PiSupply/PiJuice-mPCIe/README.md

# PiJuice-mPCIe
Resources for the PiJuice mPCIe board
