PiSupply/PiJuice-mPCIe/Hardware/README.md

# Hardware
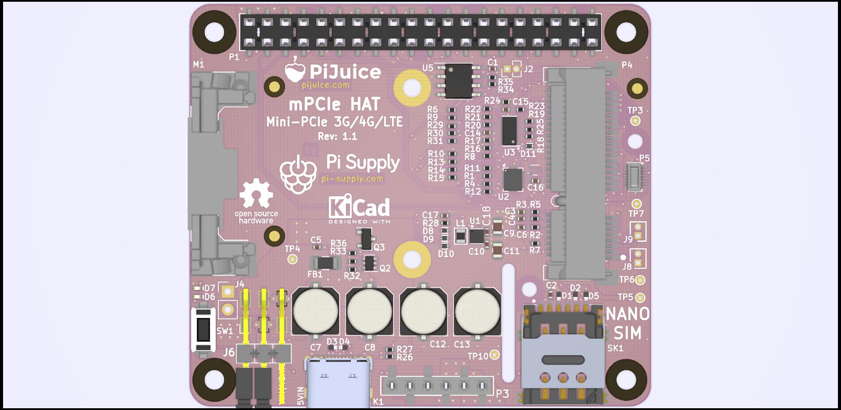
[picture p1: Hardware/Outputs/Assembly/PiJuice_mPCIe_HAT_top.jpg]
Top Side


EC25 datasheets - https://www.quectel.com/ProductDownload/EC25MiniPCIe.html

Change Log:

- V1.1_2021_12_30
    - Q2B connection fix
    - Position file generated
