PiSupply/PiJuice-mPCIe/Hardware/Outputs/gerbers/PiJuice_mPCIe_HAT_PCB_bottom.jpg

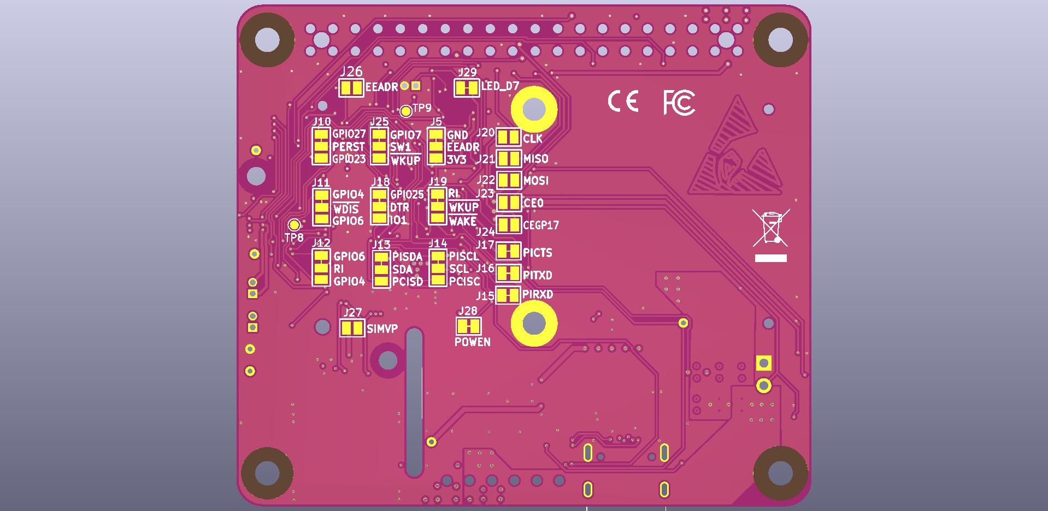
Hardware/Outputs/gerbers/PiJuice_mPCIe_HAT_PCB_bottom.jpg
