PiSupply/PiJuice-mPCIe/Hardware/Outputs/gerbers/PiJuice_mPCIe_HAT_PCB_top.jpg

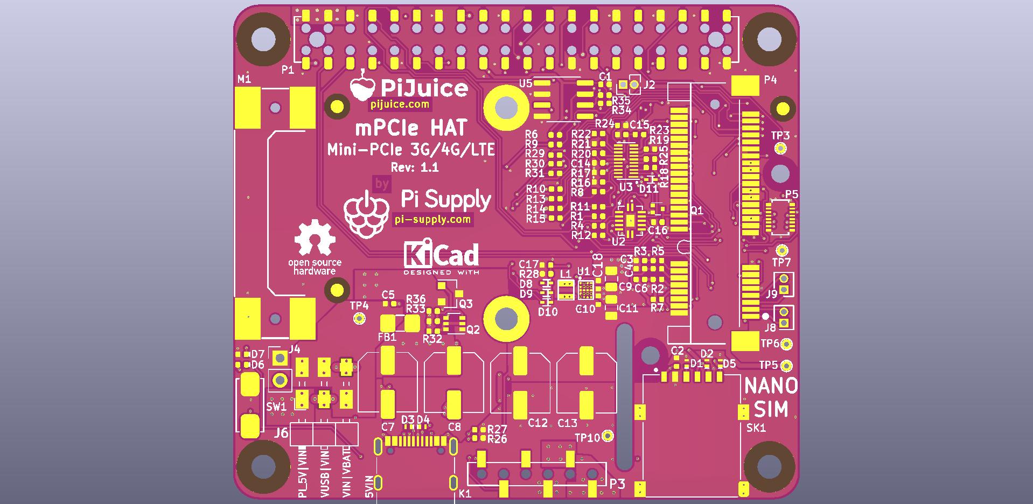
Hardware/Outputs/gerbers/PiJuice_mPCIe_HAT_PCB_top.jpg
