PiSupply/PiJuice-mPCIe/Hardware/Test_card/Outputs/mPCIe_test_card_BOM.csv

Reference | Quantity | Value | Footprint | Datasheet | Description | Part Number
R1 | 1 | 47R | Resistor_THT:R_Axial_DIN0414_L11.9mm_D4.5mm_P15.24mm_Horizontal | ~ | RES 47 OHM 1W 1% AXIAL | KNP100FR-73-47R
