PiSupply/PiJuice-mPCIe/Hardware/Outputs/Assembly/PiJuice_mPCIe_bottom.jpg

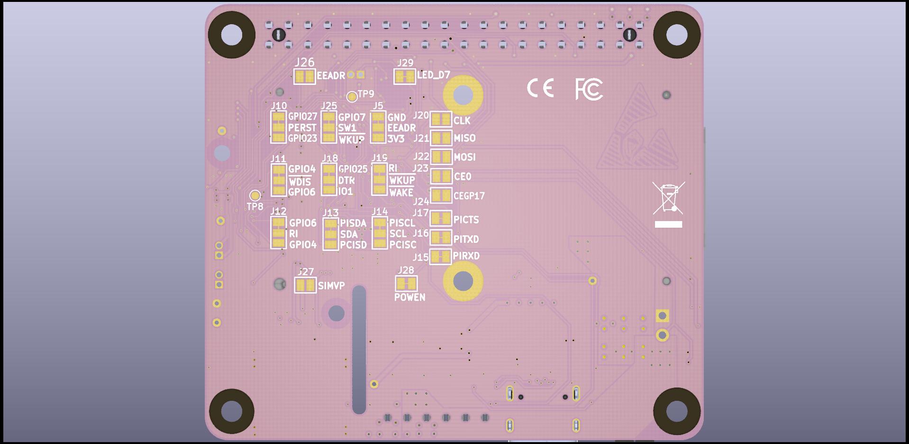
Hardware/Outputs/Assembly/PiJuice_mPCIe_bottom.jpg
