PiSupply/PiJuice-mPCIe/Hardware/Test_card/README.md

# mPCIe Test Card design 

Used for testing PiJuice mPCIe HATs 

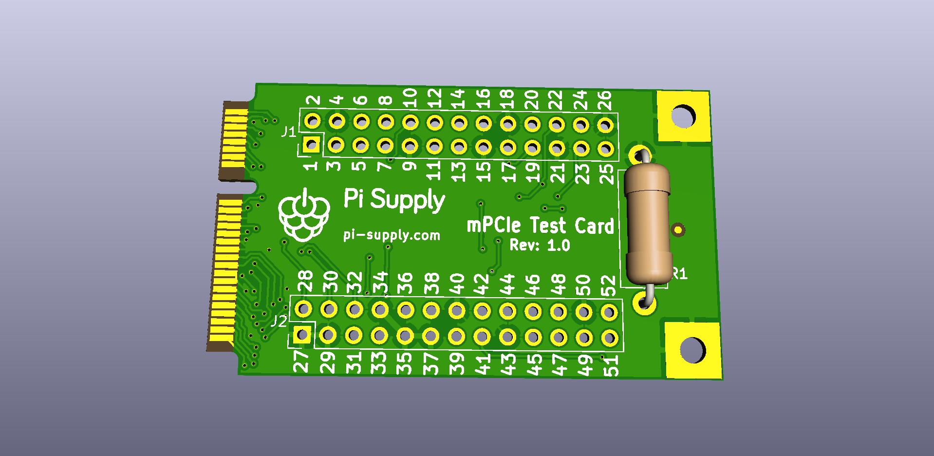
[picture p5: Hardware/Test_card/Outputs/mPCIe_test_card.jpg]
top
