PiSupply/PiJuice-mPCIe/Hardware/Test_card/mPCIe_test_card.jpg

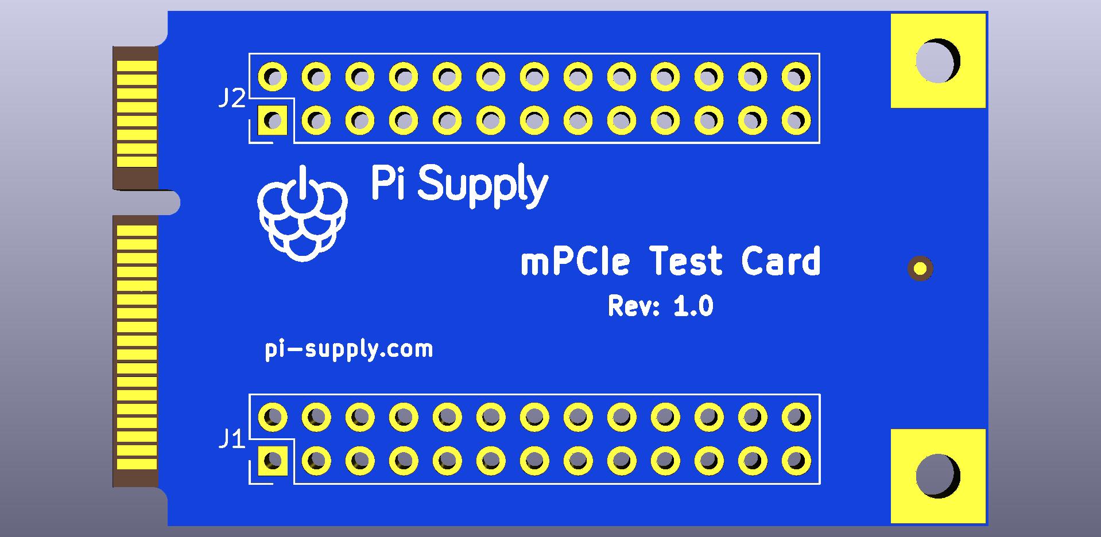
Hardware/Test_card/mPCIe_test_card.jpg
