PiSupply/PiJuice-mPCIe/Hardware/Outputs/PiJuice_mPCIe_HAT_Schematic.pdf

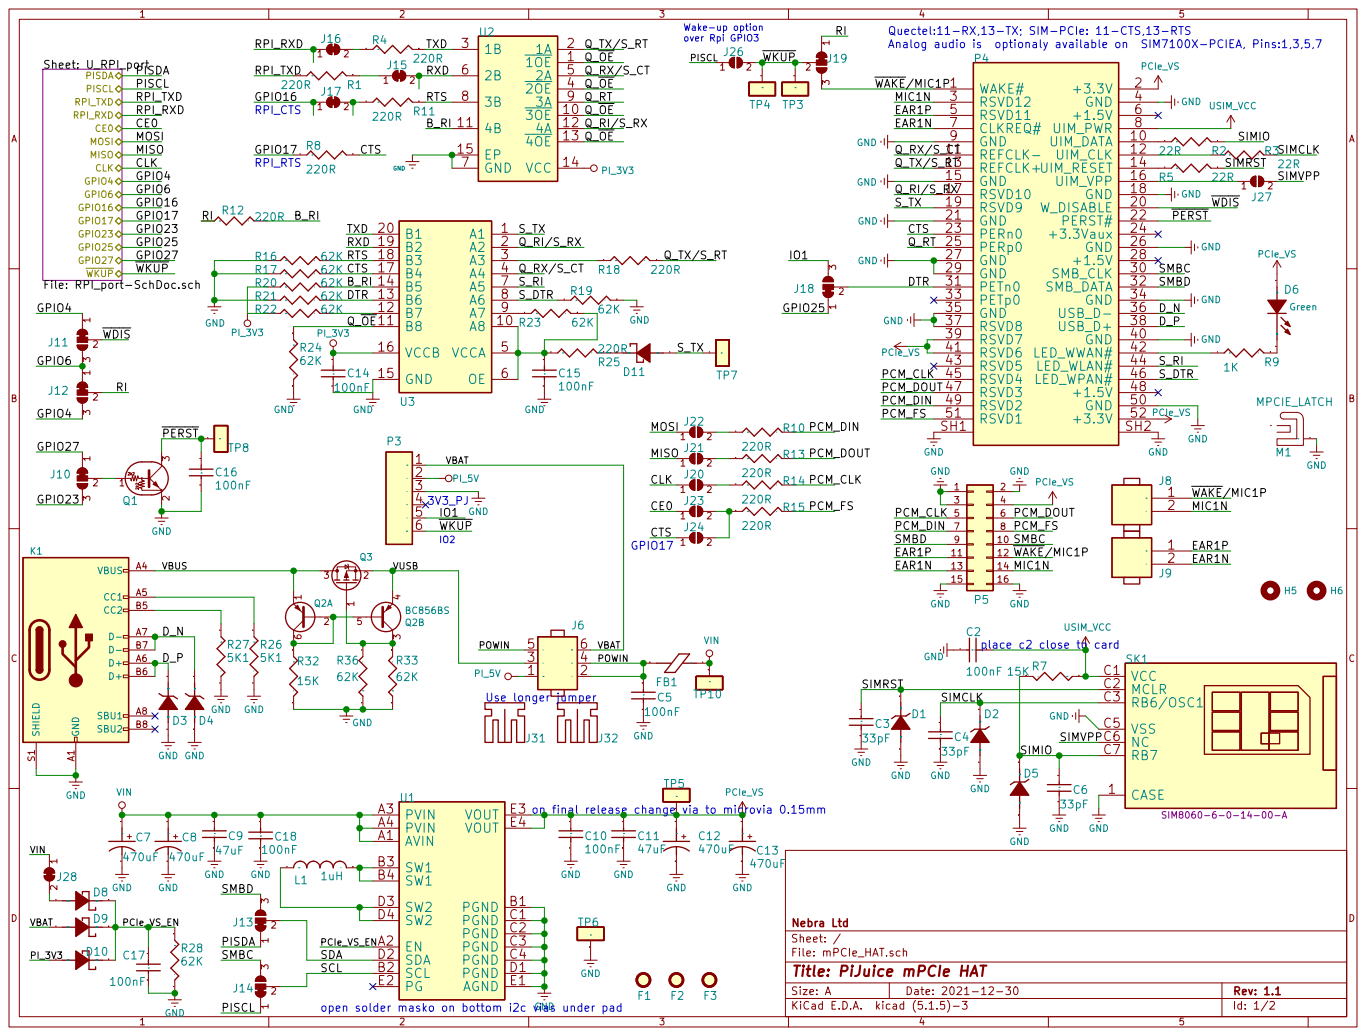
[picture p7: page 1]

Analog audio is optionaly available on SIM7100X-PCIEA, Pins:1,3,5,7

EAR1P 11 | 12 MIC1N WAKE/MIC1P
EAR1N 13 | 14

place c2 close to card

VCC C1

SIMCLK | | | RB6/OSC1 C3

SIMVPP SIMIO | VSS C5

on final release change via to microvia 0.15mm

File: mPCIe_HAT.sch Sheet: / Nebra Ltd

Id: 1/2 Title: PiJuice mPCIe HAT

open solder masko on bottom i2c vias under pad

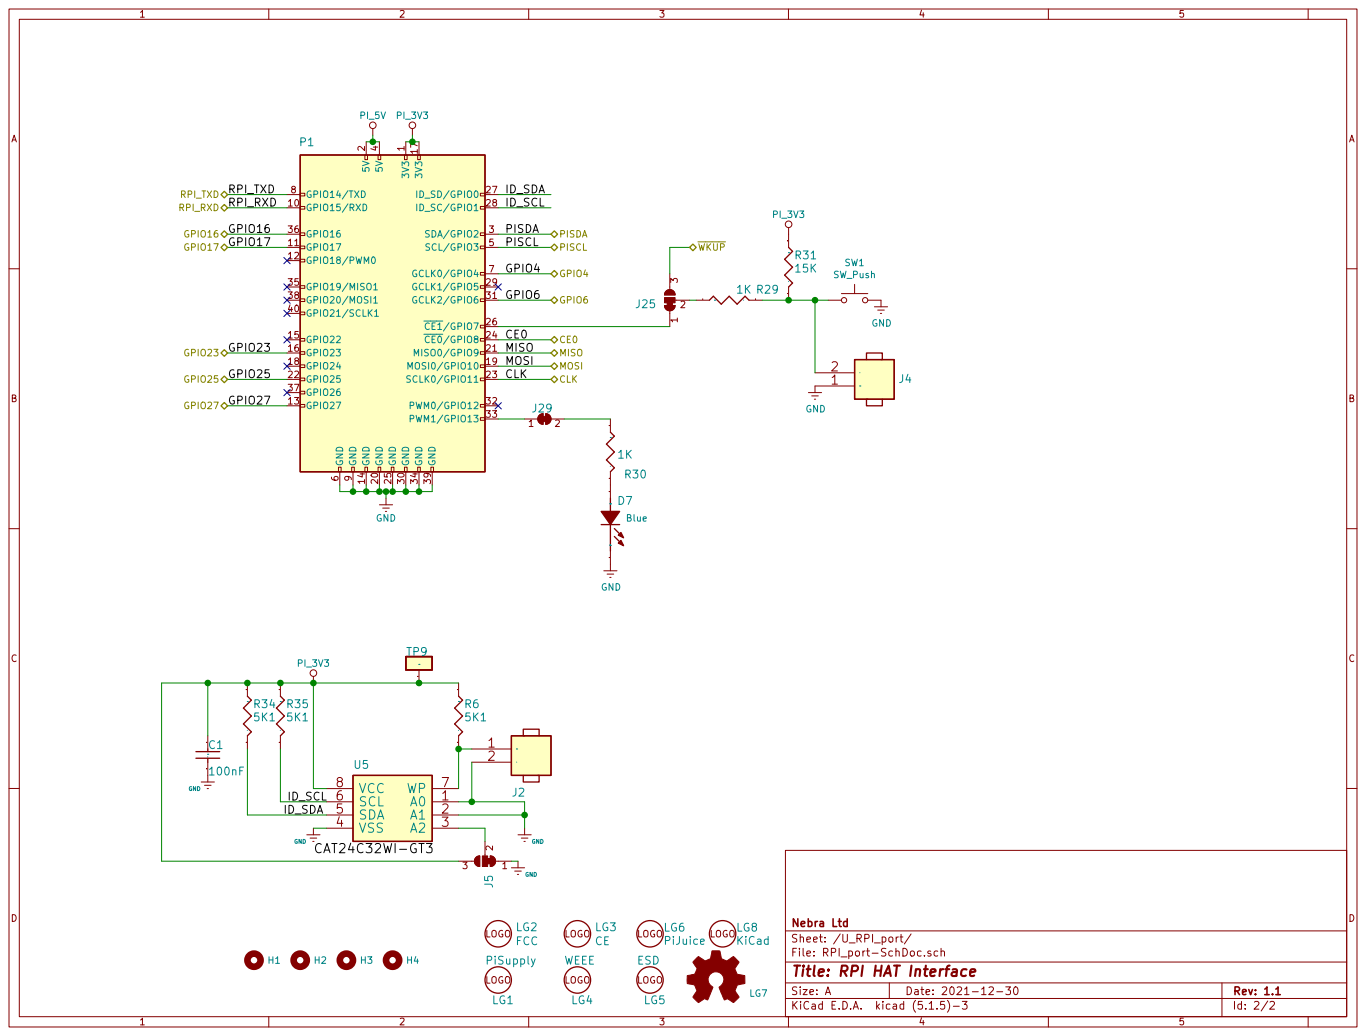
[picture p8: page 2]

3 J25 1 1 2 2 J4 GPIO4 WKUP CLK MOSI MISO

File: RPI_port-SchDoc.sch
Id: 2/2 Title: RPI HAT Interface
