PiSupply/PiJuice-mPCIe/Hardware/Outputs/PiJuice_mPCIe_HAT_Layers.pdf

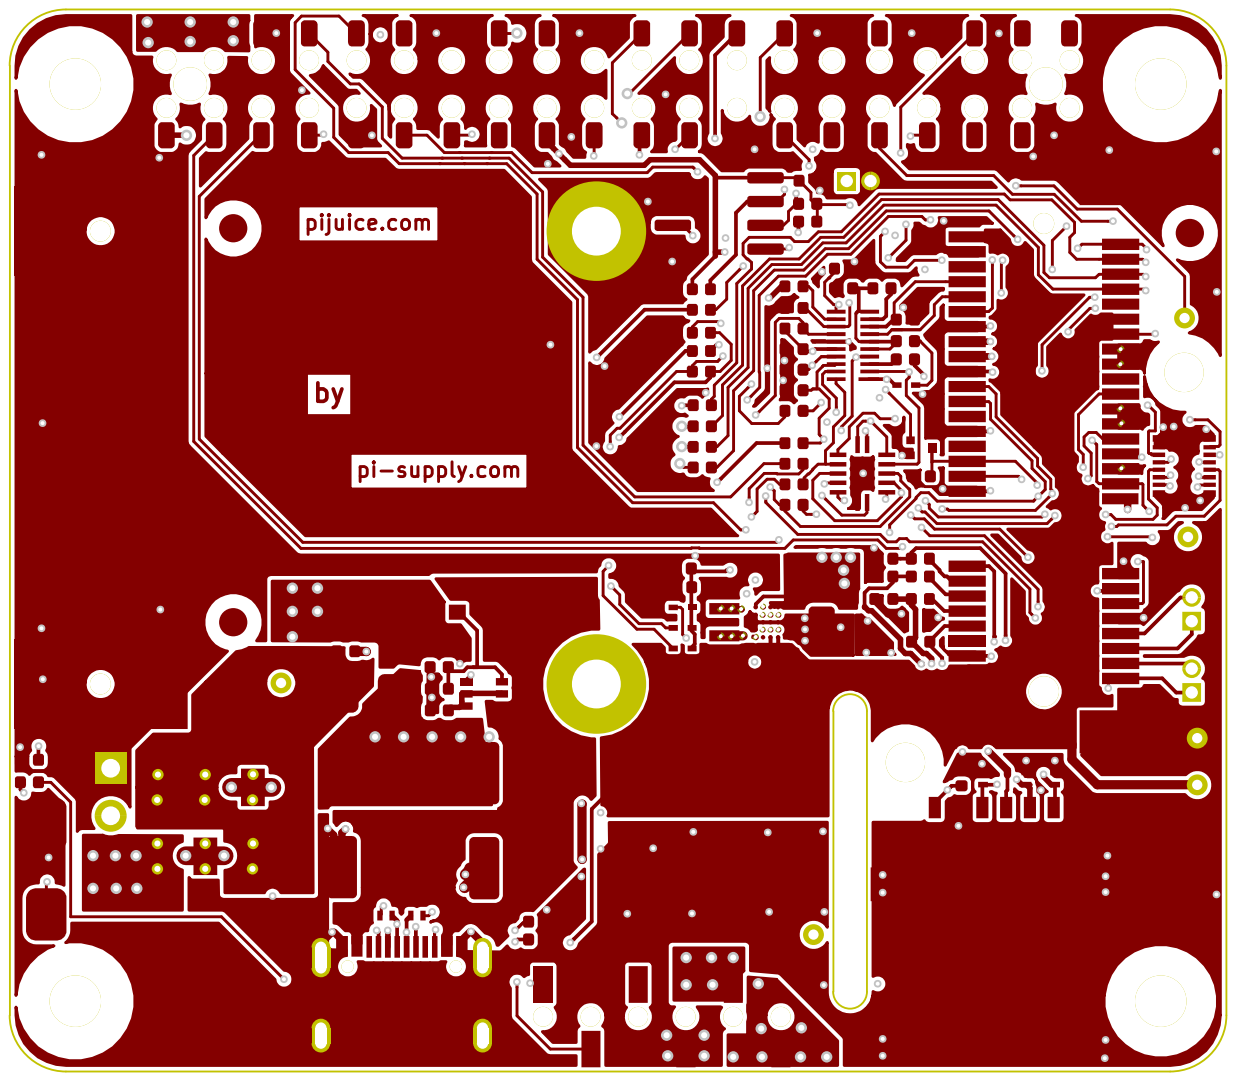
[picture p9: page 1]

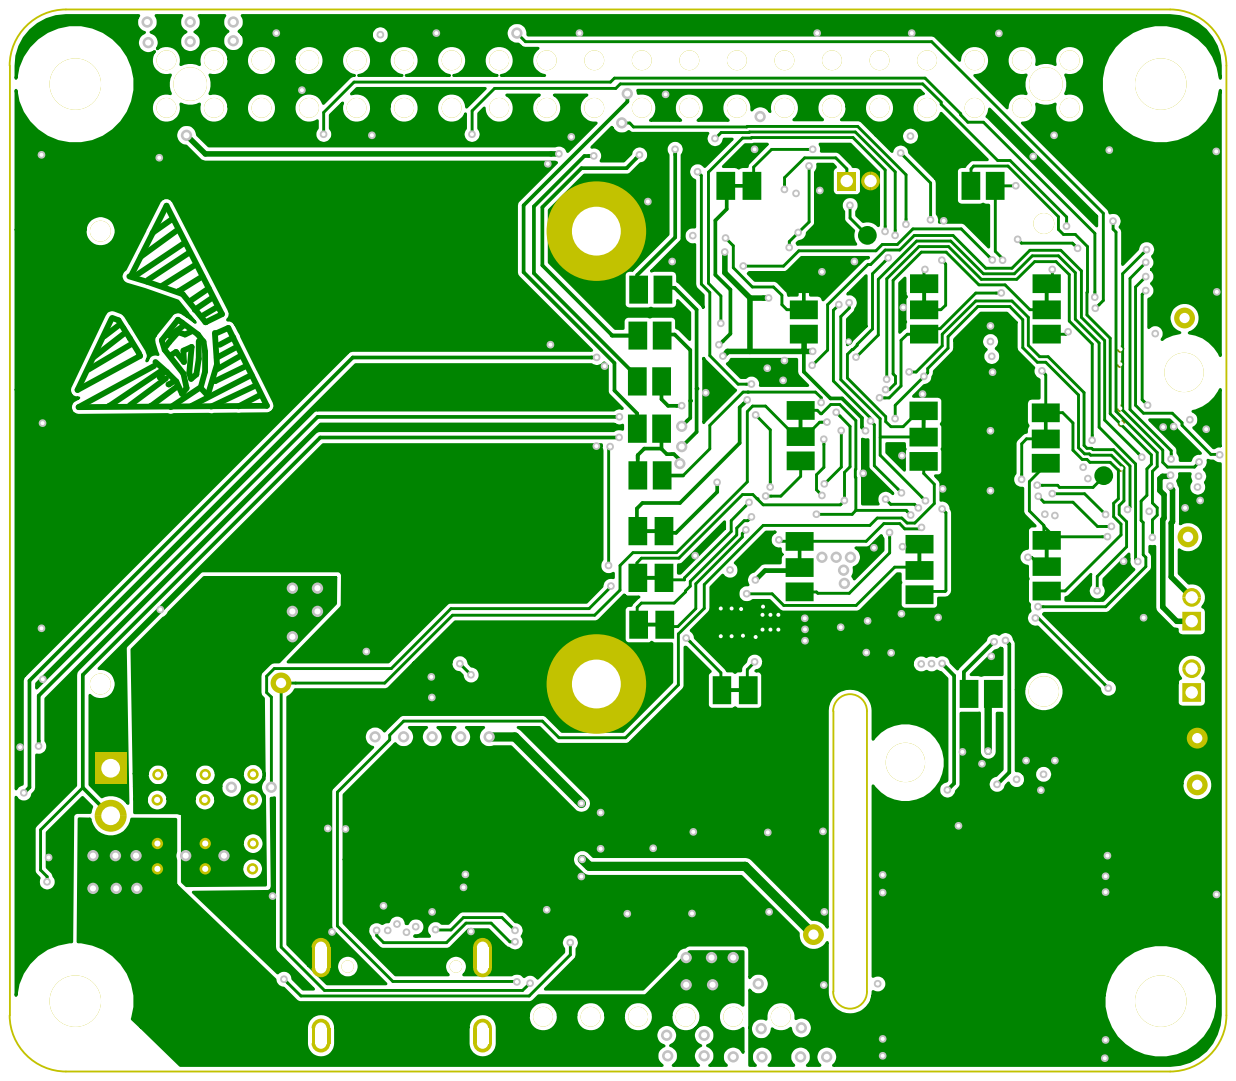
[picture p10: page 2]

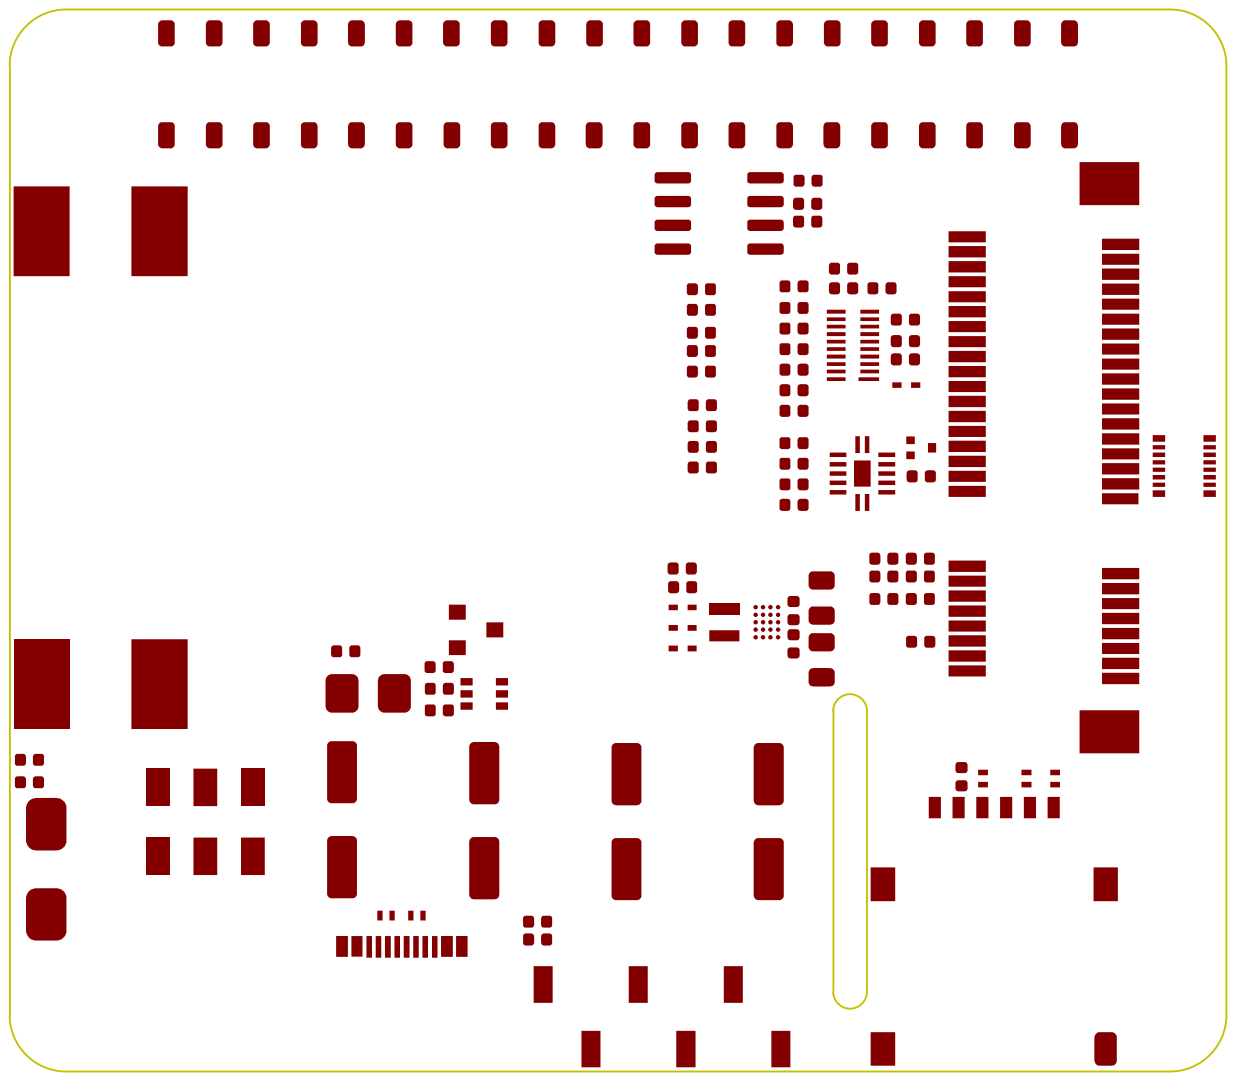
[picture p11: page 4]

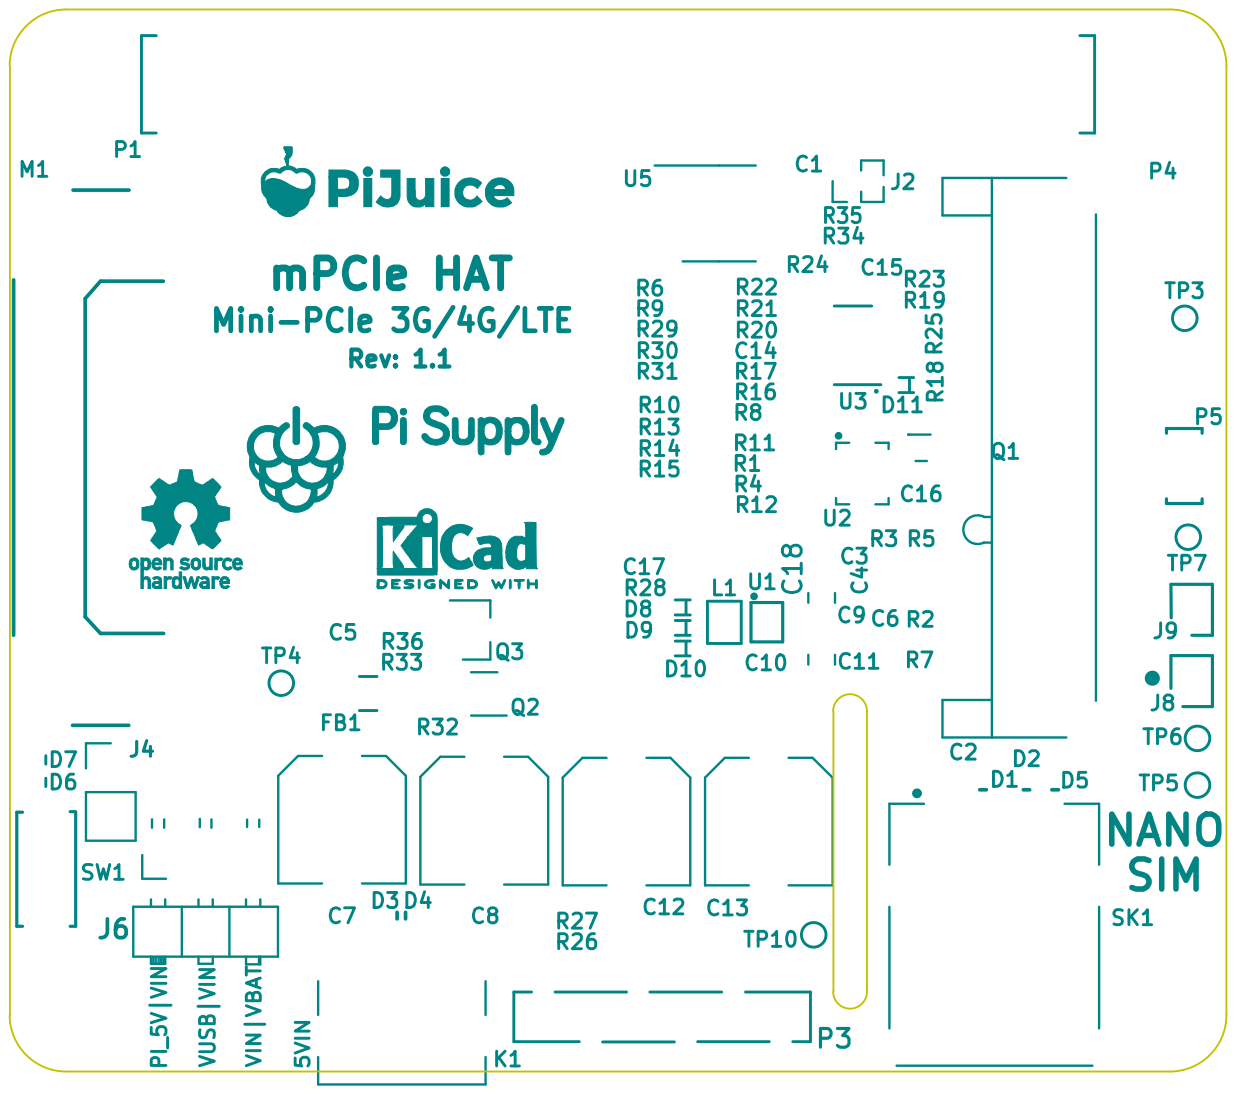
[picture p12: page 5]

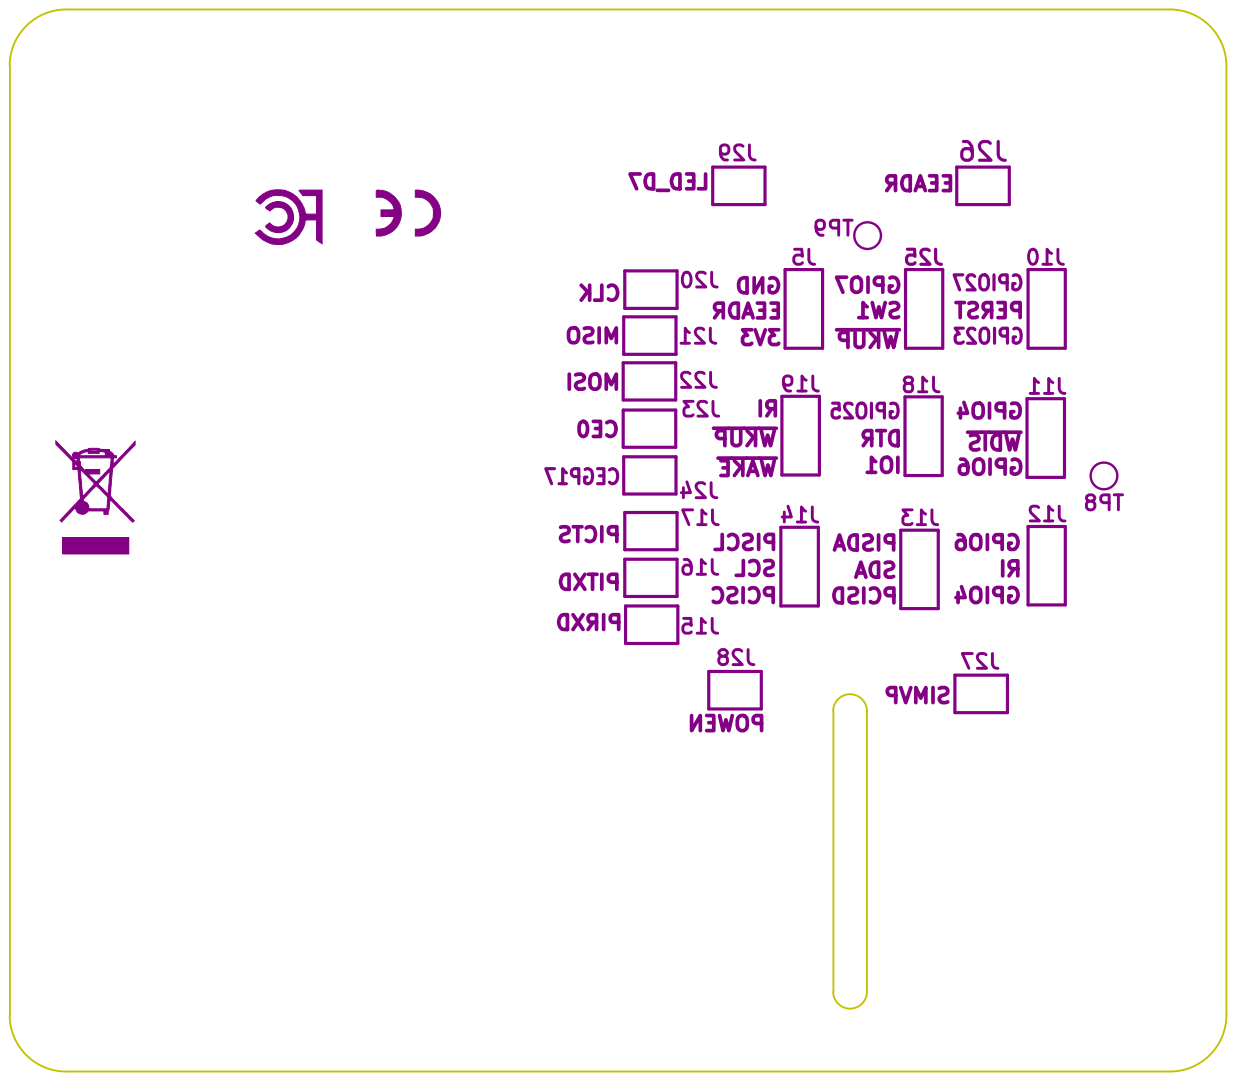
[picture p13: page 6]

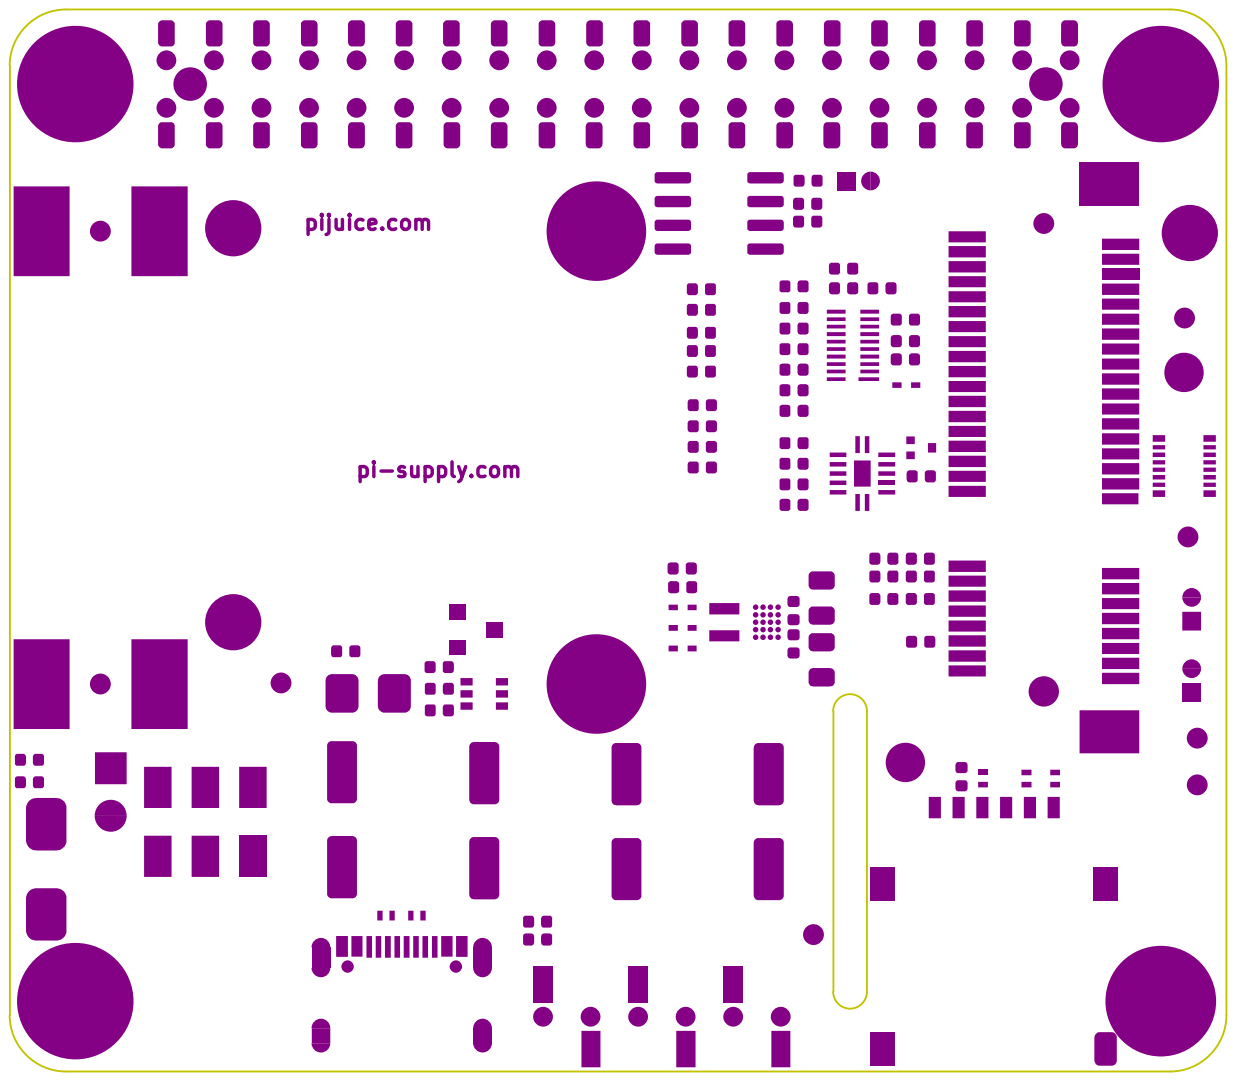
[picture p14: page 7]

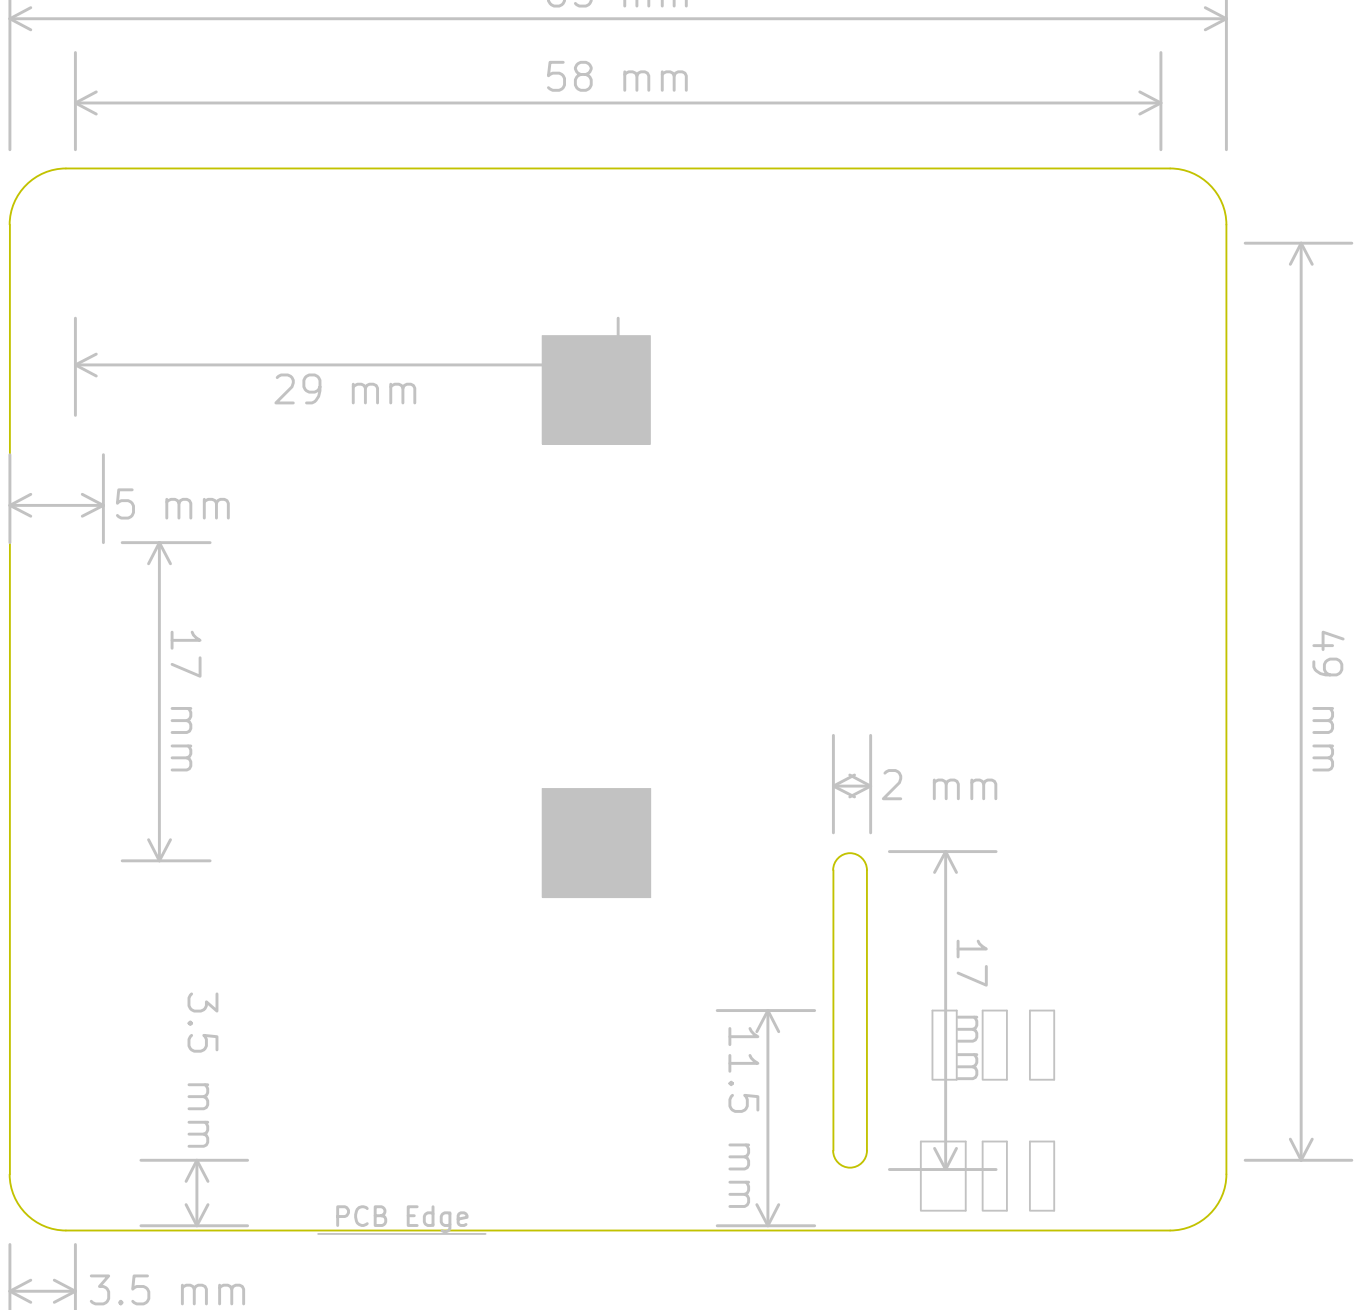
[picture p15: page 8]

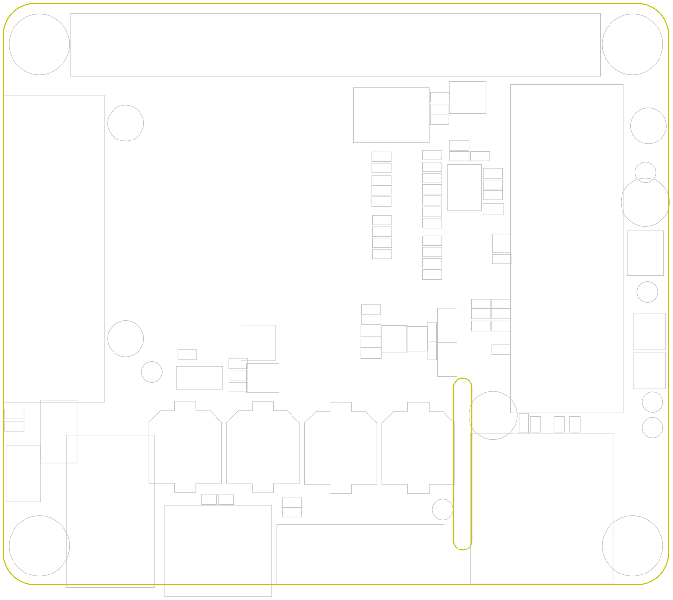
[picture p16: figure]

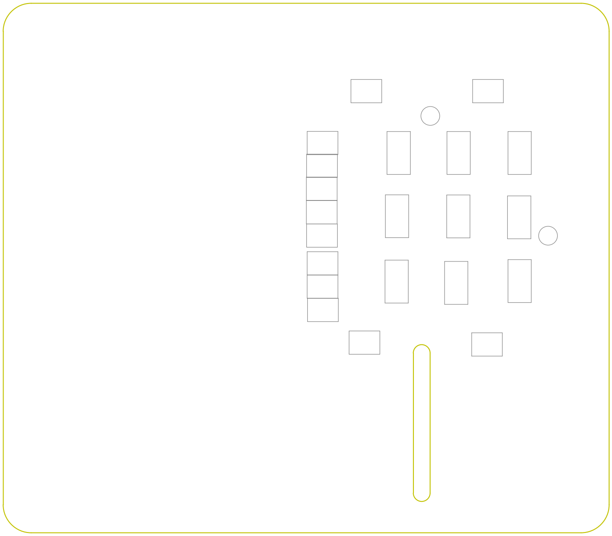
[picture p17: figure]
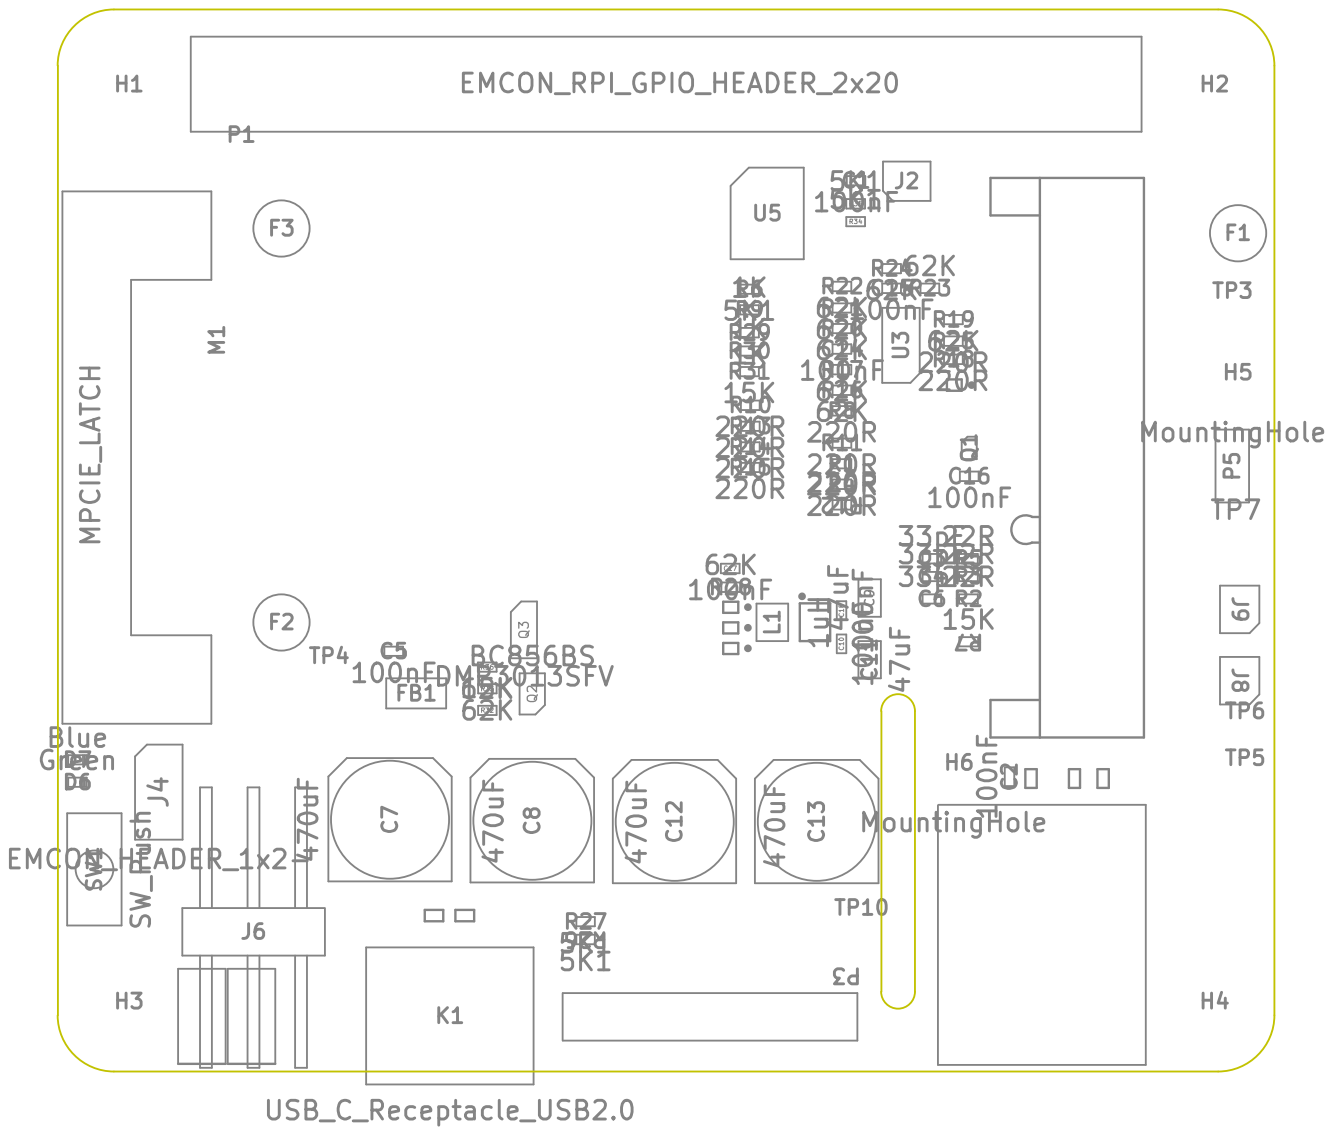
[picture p18: page 12]
