PiSupply/PiJuice-mPCIe/Hardware/mPCIe_HAT.kicad_pcb

## KiCad design Hardware/mPCIe_HAT.kicad_pcb (2021-12-30)

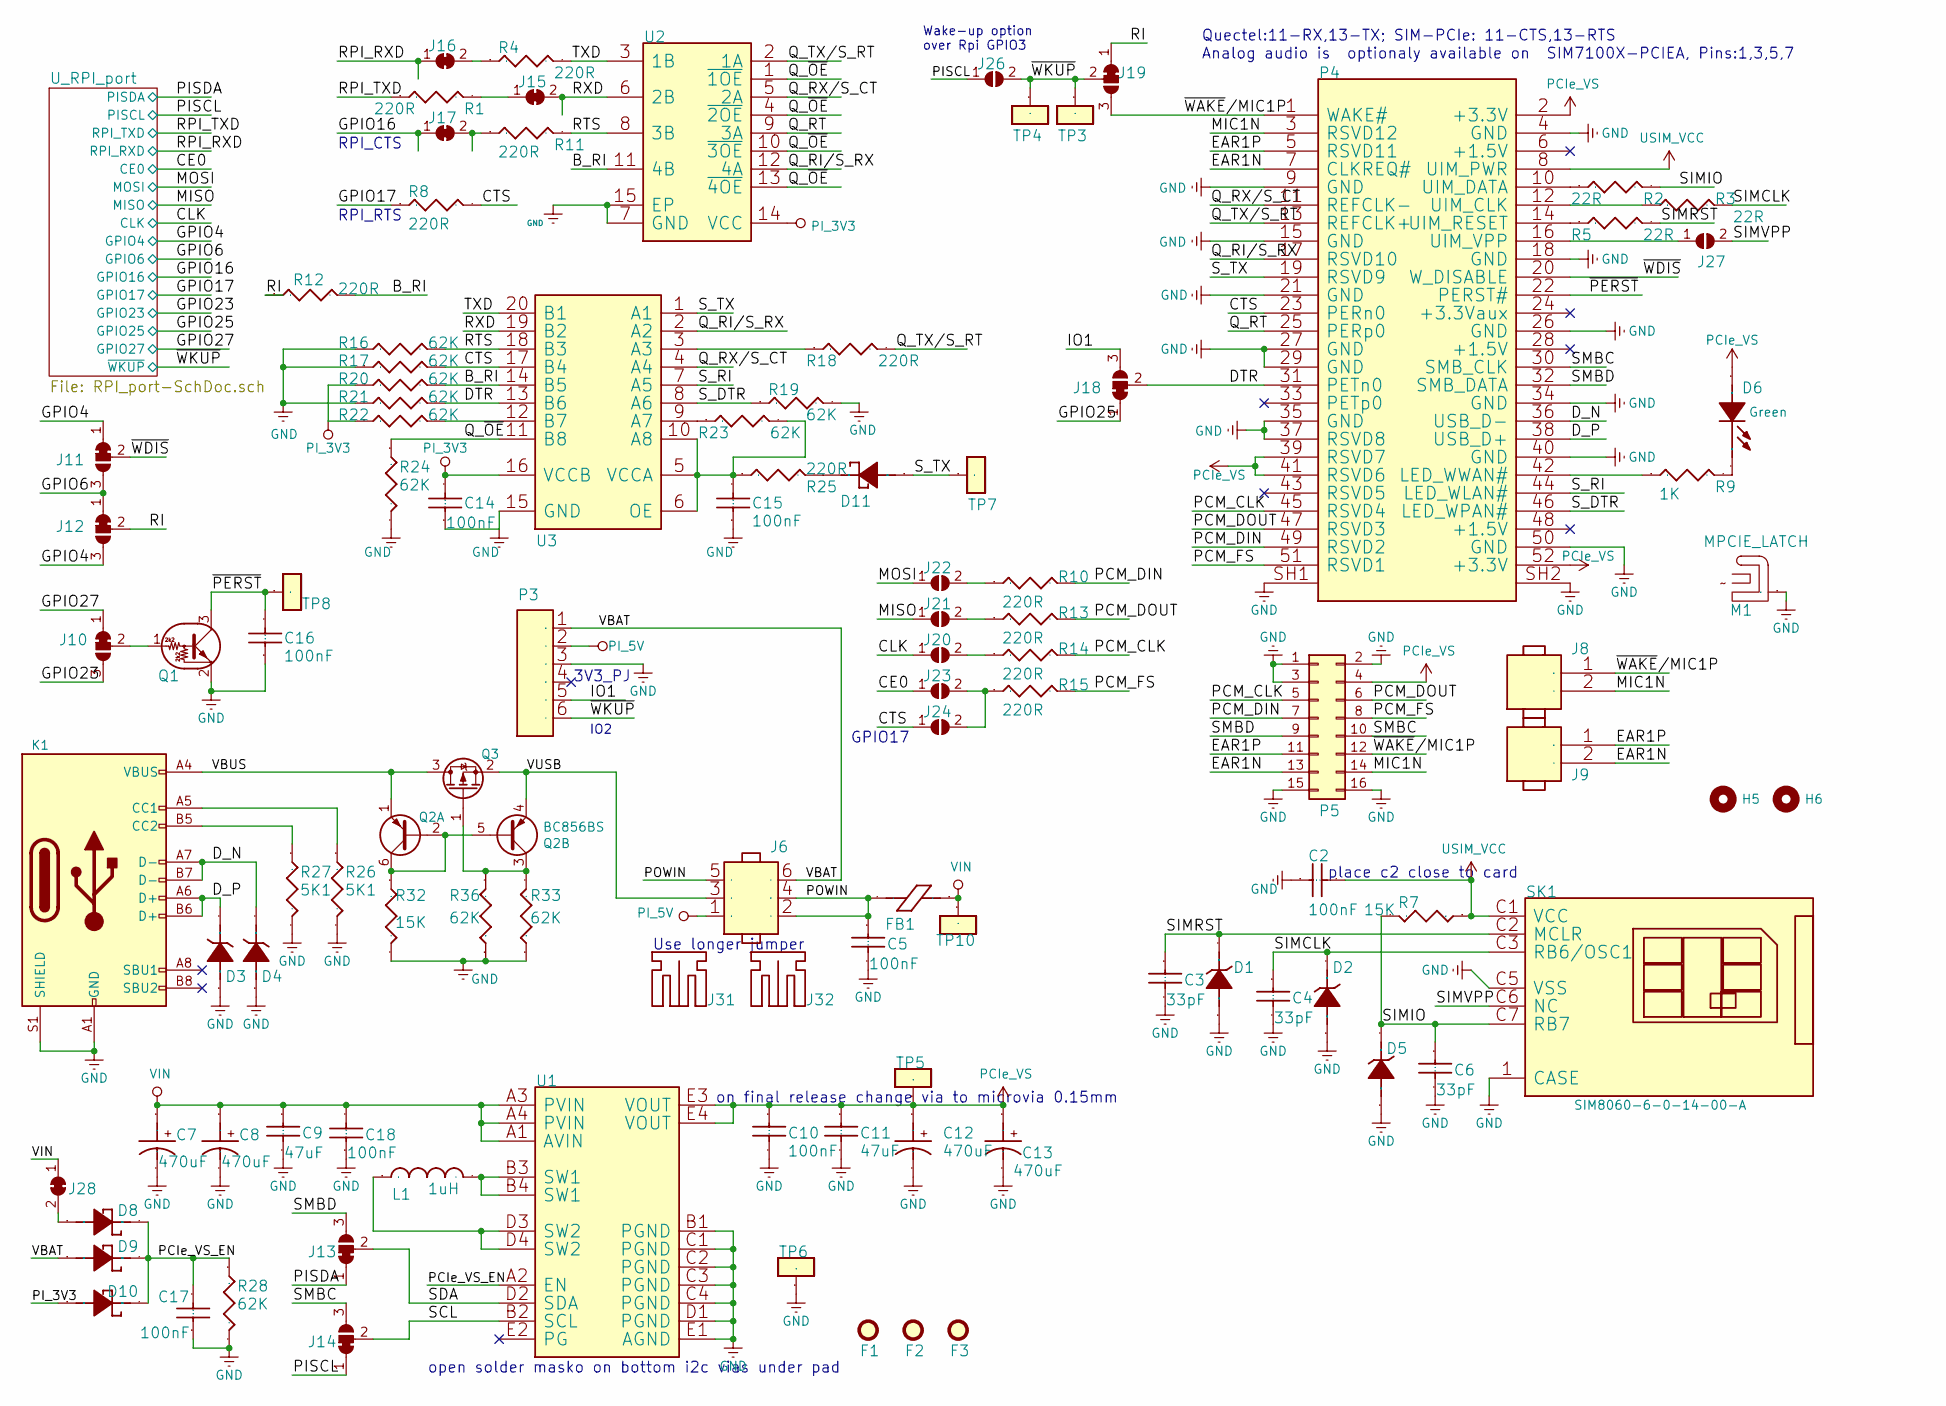
[picture p19: schematic mPCIe_HAT.sch, PiJuice mPCIe HAT]

Parts:
C2, C5, C10, C14, C15, C16, C17, C18: 100nF; C_0402_1005Metric; Part Number GRM155R61E104KA87D
C3, C4, C6: 33pF; C_0402_1005Metric; Part Number CC0402JRNP09BN330
C7, C8, C12, C13: 470uF; C_Elec_6.3x7.7; Part Number EEEFTA471XAP
C9, C11: 47uF; C_0805_2012Metric; Part Number GRM21BR61A476ME15L
D1, D2, D3, D4, D5: DIODFN2_98X58X50L26X51N; Part Number SP3030-01ETG
D6: Green; LED_0402_1005Metric; Part Number APG1005VGC-T-5MAV
D8, D9, D10, D11: SODFL1006X40N; Part Number NSR0240P2T5G
F1, F2, F3: Fiducial_1.5mm_Mask3mm
FB1: FBD_1206_3216Metric; Part Number FBMJ3216HS480NT
H5, H6: MountingHole; MountingHole_2.1mm
J6: PinHeader_2x03_P2.54mm_Horizontal_SMD; Part Number 11144
J8, J9: PinHeader_1x02_P1.27mm_Vertical
J10, J11, J12, J13, J14, J18, J19: SolderJumper-3_P1.3mm_Bridged12_Pad1x2.2mm_NumberLabels
J15, J16, J17, J28: SolderJumper-2_P1.3mm_Bridged_Pad1.0x1.5mm
J20, J21, J22, J23, J24, J26, J27: SolderJumper-2_P1.3mm_Open_Pad1.0x1.5mm
J31, J32: ShortingJumperCapHorizontal-2_P2.54mm; Part Number SNT-100-BK-G
K1: USB_C_Receptacle_USB2.0; USB_C_Receptacle_GCT_USB4105-GF-A; Part Number TYPE-C.16PIN.040
L1: 1uH; L_Murata_DFE2016; Part Number DFE201612E-1R0M
M1: MPCIE_LATCH; MPCIE_LATCH_0480994000; Part Number 0480994000
P3: CONN_1X6_SMT_Through_Board; Part Number BG125-06-A-1-1-0440-N-C
P4: TE_1775838-2; Part Number 1775838-2
P5: DF40C-12DP-0.4V-51; Part Number DF40C-12DP-0.4V(51)
Q1: SOT-723; Part Number DTC023EMT2L
Q2: BC856BS; SOT-363_SC-70-6; Part Number BC856S
Q3: DMP3013SFV; SOT-23; Part Number DMP2035U-7
R1, R4, R8, R10, R11, R12, R13, R14, R15, R18, R25: 220R; R_0402_1005Metric; Part Number ERJ2RKF2200X
R2, R3, R5: 22R; R_0402_1005Metric; Part Number RC0402FR-0722RL
R7, R32: 15K; R_0402_1005Metric; Part Number RC0402JR-0715KL
R9: 1K; R_0402_1005Metric; Part Number RT0402FRE071KL
R16, R17, R19, R20, R21, R22, R23, R24, R28, R33, R36: 62K; R_0402_1005Metric; Part Number RC0402FR-0762KL
R26, R27: 5K1; R_0402_1005Metric; Part Number RC0402FR-075K1L
SK1: NANO_SIM8060-6-0-14-00-A; Part Number SIM8060-6-0-14-00-A
TP3, TP4, TP5, TP6, TP7, TP10: TestPoint_THTPad_D1.1mm_Drill0.55mm
TP8: TestPoint_Pad_D1.0mm
U1: BGA20N40P4X5_199X194X60N; Part Number FAN49103AUC340X
U2: DHVQFN14-2.5x3.kicad_mod; Part Number 74CBTLV3125BQ,115
U3: USON-20_2x4mm_P0.4mm; Part Number TXB0108DQSR

Connections:
/B_RI: R12.2, R20.2, U2.11 (4B), U3.14 (B5)
/CE0: J23.1 (A); also elsewhere on the board
/CLK: J20.1 (A); also elsewhere on the board
/CTS: J24.1 (A), P4.23 (PERn0), R8.2, R17.2, U3.17 (B4)
/DTR: J18.2 (C), P4.31 (PETn0), R21.2, U3.13 (B6)
/D_N: D4.2 (CATHODE), K1.A7 (D-), K1.B7 (D-), P4.36 (USB_D-)
/D_P: D3.2 (CATHODE), K1.A6 (D+), K1.B6 (D+), P4.38 (USB_D+)
/EAR1N: J9.2, P4.7 (CLKREQ#), P5.13
/EAR1P: J9.1, P4.5 (RSVD11), P5.11
/GPIO4: J11.1 (A), J12.3 (B); also elsewhere on the board
/GPIO6: J11.3 (B), J12.1 (A); also elsewhere on the board
/GPIO16: J17.1 (A); also elsewhere on the board
/GPIO17: R8.1; also elsewhere on the board
/GPIO23: J10.3 (B); also elsewhere on the board
/GPIO25: J18.1 (A); also elsewhere on the board
/GPIO27: J10.1 (A); also elsewhere on the board
/IO1: J18.3 (B), P3.5
/MIC1N: J8.2, P4.3 (RSVD12), P5.14
/MISO: J21.1 (A); also elsewhere on the board
/MOSI: J22.1 (A); also elsewhere on the board
/PCIe_VS_EN: C17.2, D8.2 (CATHODE), D9.2 (CATHODE), D10.2 (CATHODE), R28.1, U1.A2 (EN)
/PCM_CLK: P4.45 (RSVD4), P5.5, R14.2
/PCM_DIN: P4.49 (RSVD2), P5.7, R10.2
/PCM_DOUT: P4.47 (RSVD3), P5.6, R13.2
/PCM_FS: P4.51 (RSVD1), P5.8, R15.2
/PISCL: J14.1 (A), J26.1 (A); also elsewhere on the board
/PISDA: J13.1 (A); also elsewhere on the board
/POWIN: C5.1, FB1.2, J6.2, J6.4, J6.5
/Q_RI/S_RX: P4.17 (RSVD10), U2.12 (4A), U3.2 (A2)
/Q_RT: P4.25 (PERp0), U2.9 (3A)
/Q_RX/S_CT: P4.11 (REFCLK-), U2.5 (2A), U3.4 (A4)
/Q_TX/S_RT: P4.13 (REFCLK+), R18.2, U2.2 (1A)
/Q_~OE~: R24.1, U2.1 (~1OE), U2.4 (~2OE), U2.10 (~3OE), U2.13 (~4OE), U3.11 (B8)
/RI: J12.2 (C), J19.1 (A), R12.1
/RPI_RXD: J16.1 (A); also elsewhere on the board
/RPI_TXD: R1.1; also elsewhere on the board
/RTS: R11.2, R16.2, U2.8 (3B), U3.18 (B3)
/RXD: J15.2 (B), U2.6 (2B), U3.19 (B2)
/SCL: J14.2 (C), U1.B2 (SCL)
/SDA: J13.2 (C), U1.D2 (SDA)
/SIMCLK: C4.1, D2.2 (CATHODE), R3.2, SK1.C3 (RB6/OSC1)
/SIMIO: C6.1, D5.2 (CATHODE), R2.2, R7.2, SK1.C7 (RB7)
/SIMRST: C3.1, D1.2 (CATHODE), R5.2, SK1.C2 (MCLR)
/SIMVPP: J27.2 (B), SK1.C6 (NC)
/SMBC: J14.3 (B), P4.30 (SMB_CLK), P5.10
/SMBD: J13.3 (B), P4.32 (SMB_DATA), P5.9
/S_DTR: P4.46 (LED_WPAN#), R19.1, U3.8 (A6)
/S_RI: P4.44 (LED_WLAN#), U3.7 (A5)
/S_TX: D11.1 (ANODE), P4.19 (RSVD9), TP7.1, U3.1 (A1)
/TXD: R4.2, U2.3 (1B), U3.20 (B1)
/VBAT: D9.1 (ANODE), J6.6, P3.1
/VBUS: K1.A4 (VBUS), K1.A9 (VBUS), K1.B4 (VBUS), K1.B9 (VBUS), Q2.1 (E1), Q3.3 (D)
/VUSB: J6.3, Q2.4 (E2), Q3.2 (S)
/~PERST~: C16.2, P4.22 (PERST#), Q1.3 (C), TP8.1
/~WAKE~/MIC1P: J8.1, J19.3 (B), P4.1 (WAKE#), P5.12
/~WDIS~: J11.2 (C), P4.20 (W_DISABLE)
/~WKUP~: J19.2 (C), J26.2 (B), P3.6, TP3.1, TP4.1; also elsewhere on the board
GND: C2.1, C3.2, C4.2, C5.2, C6.2, C7.2, C8.2, C9.2, C10.2, C11.2, C12.2, C13.2, C14.1, C15.1, C16.1, C17.1, C18.1, D1.1 (ANODE), D2.1 (ANODE), D3.1 (ANODE), D4.1 (ANODE), D5.1 (ANODE), K1.A1 (GND), K1.A12 (GND), K1.B1 (GND), K1.B12 (GND), K1.S1 (SHIELD), M1.1, P3.3, P4.4 (GND), P4.9 (GND), P4.15 (GND), P4.18 (GND), P4.21 (GND), P4.26 (GND), P4.27 (GND), P4.29 (GND), P4.34 (GND), P4.35 (GND), P4.37 (RSVD8), P4.40 (GND), P4.50 (GND), P4.SH1, P4.SH2, P5.1, P5.2, P5.3, P5.15, P5.16, Q1.2 (E), R16.1, R17.1, R19.2, R21.1, R24.2, R26.2, R27.2, R28.2, R32.2, R33.1, R36.1, SK1.1 (CASE), SK1.C5 (VSS), TP6.1, U1.B1 (PGND), U1.C1 (PGND), U1.C2 (PGND), U1.C3 (PGND), U1.C4 (PGND), U1.D1 (PGND), U1.E1 (AGND), U2.7 (GND), U2.15 (EP), U3.15 (GND); also elsewhere on the board
unnamed: C15.2, R23.2, R25.1, U3.5 (VCCA), U3.6 (OE), U3.10 (A8)
unnamed: D6.2 (CATHODE), R9.2
unnamed: D8.1 (ANODE), J28.2 (B)
unnamed: D11.2 (CATHODE), R25.2
unnamed: J10.2 (C), Q1.1 (B)
unnamed: J15.1 (A), R1.2
unnamed: J16.2 (B), R4.1
unnamed: J17.2 (B), R11.1
unnamed: J20.2 (B), R14.1
unnamed: J21.2 (B), R13.1
unnamed: J22.2 (B), R10.1
unnamed: J23.2 (B), J24.2 (B), R15.1
unnamed: J27.1 (A), P4.16 (UIM_VPP)
unnamed: K1.A5 (CC1), R26.1
unnamed: K1.B5 (CC2), R27.1
unnamed: L1.1, U1.D3 (SW2), U1.D4 (SW2)
unnamed: L1.2, U1.B3 (SW1), U1.B4 (SW1)
unnamed: P4.10 (UIM_DATA), R2.1
unnamed: P4.12 (UIM_CLK), R3.1
unnamed: P4.14 (UIM_RESET), R5.1
unnamed: P4.42 (LED_WWAN#), R9.1
unnamed: Q2.2 (B1), Q2.5 (B2), Q2.6 (C1), R32.1
unnamed: Q2.3 (C2), Q3.1 (G), R33.2, R36.2
unnamed: R18.1, U3.3 (A3)
unnamed: R22.2, U3.12 (B7)
unnamed: R23.1, U3.9 (A7)
PCIe_VS: C10.1, C11.1, C12.1, C13.1, D6.1 (ANODE), P4.2 (+3.3V), P4.39 (RSVD7), P4.41 (RSVD6), P4.52 (+3.3V), P5.4, TP5.1, U1.E3 (VOUT), U1.E4 (VOUT)
PI_3V3: C14.2, D10.1 (ANODE), R20.1, R22.1, U2.14 (VCC), U3.16 (VCCB); also elsewhere on the board
PI_5V: J6.1, P3.2; also elsewhere on the board
USIM_VCC: C2.2, P4.8 (UIM_PWR), R7.1, SK1.C1 (VCC)
VIN: C7.1, C8.1, C9.1, C18.2, FB1.1, J28.1 (A), TP10.1, U1.A1 (AVIN), U1.A3 (PVIN), U1.A4 (PVIN)

Notes on the sheet:
Analog audio is optionaly available on SIM7100X-PCIEA, Pins:1,3,5,7
Quectel:11-RX,13-TX; SIM-PCIe: 11-CTS,13-RTS
on final release change via to microvia 0.15mm
open solder masko on bottom i2c vias under pad
place c2 close to card
RPI_RTS
RPI_CTS
Wake-up option over Rpi GPIO3
GPIO17
IO2
3V3_PJ
Use longer jumper

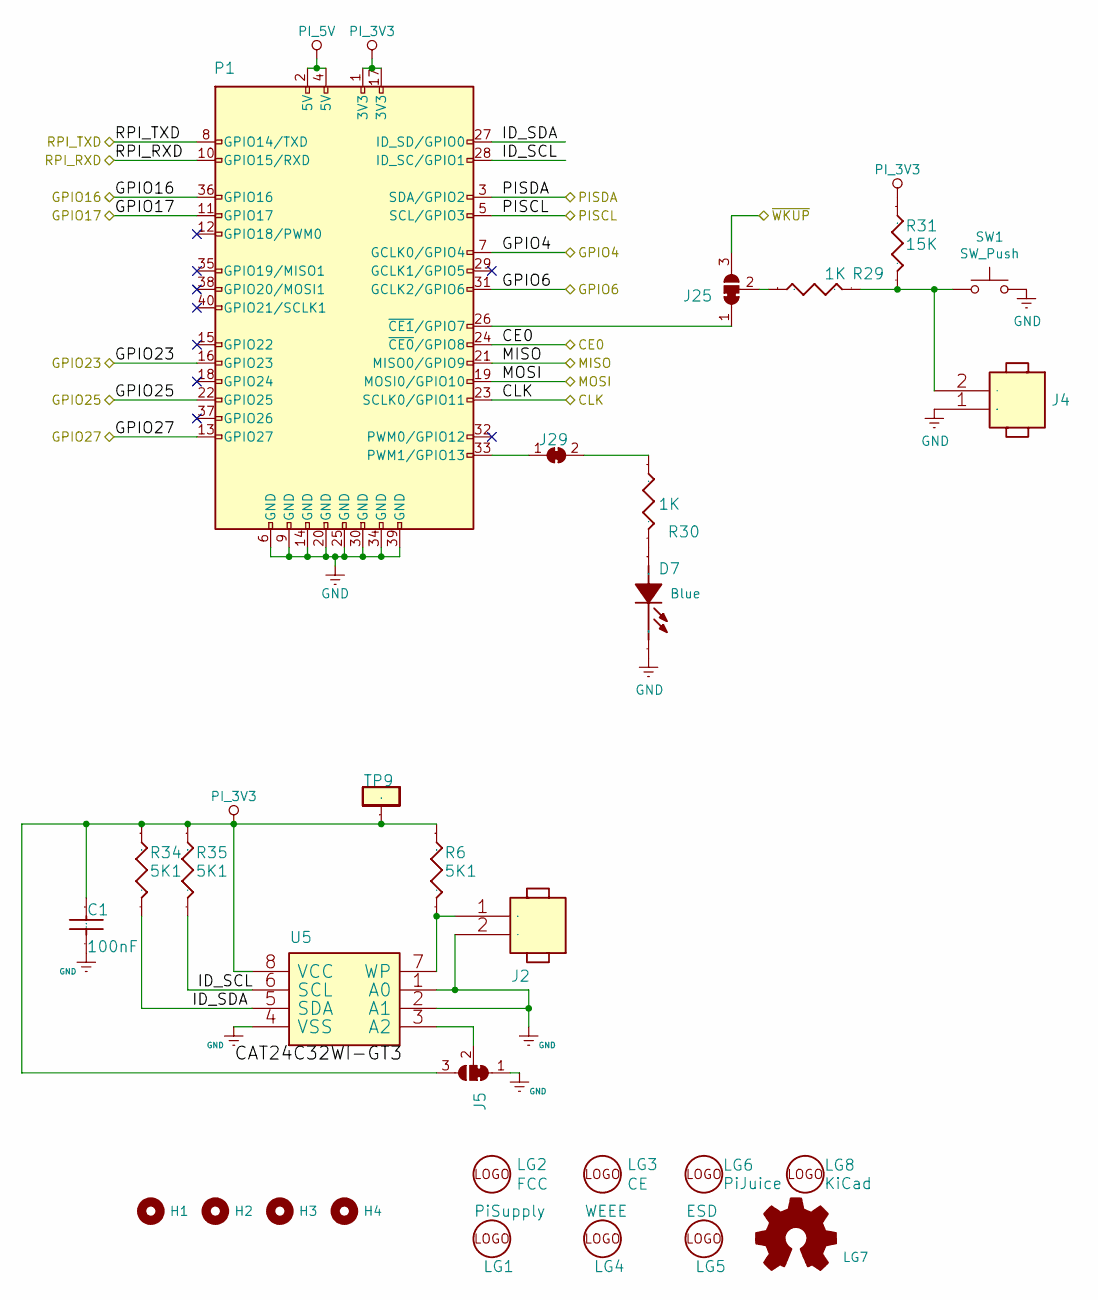
[picture p20: schematic RPI_port-SchDoc.sch, RPI HAT Interface]

Parts:
C1: 100nF; C_0402_1005Metric; Part Number GRM155R61E104KA87D
D7: Blue; LED_0402_1005Metric; Part Number APG1005PBC-T-5MAV
H1, H2, H3, H4: MountingHole; MountingHole_RPI_2.7mm_M2.5
J2: PinHeader_1x02_P1.27mm_Vertical
J4: EMCON_HEADER_1x2-; PinHeader_1x02_P2.54mm_Vertical
J5, J25: jumper; SolderJumper-3_P1.3mm_Bridged12_Pad1x2.2mm_NumberLabels
J29: SolderJumper-2_P1.3mm_Bridged_Pad1.0x1.5mm
LG1: PiSupply
LG2: FCC
LG3: CE
LG4: WEEE; WEEE-Logo_4.2x6mm_SilkScreen
LG5: ESD; Symbol_ESD-Logo_CopperTop
LG6: PiJuice; Pijuice
LG7: Logo_Open_Hardware_Small; oshw
LG8: KiCad
P1: EMCON_RPI_GPIO_HEADER_2x20; CONN_2X20_SMT_Through_Board; Part Number REF-182665-01
R6, R34, R35: 5K1; R_0402_1005Metric; Part Number RC0402FR-075K1L
R29, R30: 1K; R_0402_1005Metric; Part Number RT0402FRE071KL
R31: 15K; R_0402_1005Metric; Part Number RC0402JR-0715KL
SW1: SW_Push; SW_TACT_6X3; Part Number TL3302AF180QJ
TP9: TestPoint_Pad_D1.0mm
U5: SOIC-8_3.9x4.9mm_P1.27mm; Part Number CAT24C32WI-GT3

Connections:
/CE0: P1.24 (~CE0~/GPIO8); also elsewhere on the board
/CLK: P1.23 (SCLK0/GPIO11); also elsewhere on the board
/GPIO4: P1.7 (GCLK0/GPIO4); also elsewhere on the board
/GPIO6: P1.31 (GCLK2/GPIO6); also elsewhere on the board
/GPIO16: P1.36 (GPIO16); also elsewhere on the board
/GPIO17: P1.11 (GPIO17); also elsewhere on the board
/GPIO23: P1.16 (GPIO23); also elsewhere on the board
/GPIO25: P1.22 (GPIO25); also elsewhere on the board
/GPIO27: P1.13 (GPIO27); also elsewhere on the board
/MISO: P1.21 (MISO0/GPIO9); also elsewhere on the board
/MOSI: P1.19 (MOSI0/GPIO10); also elsewhere on the board
/PISCL: P1.5 (SCL/GPIO3); also elsewhere on the board
/PISDA: P1.3 (SDA/GPIO2); also elsewhere on the board
/RPI_RXD: P1.10 (GPIO15/RXD); also elsewhere on the board
/RPI_TXD: P1.8 (GPIO14/TXD); also elsewhere on the board
/U_RPI_port/ID_SCL: P1.28 (ID_SC/GPIO1), R35.2, U5.6 (SCL)
/U_RPI_port/ID_SDA: P1.27 (ID_SD/GPIO0), R34.2, U5.5 (SDA)
/~WKUP~: J25.3 (B); also elsewhere on the board
GND: C1.2, D7.2 (CATHODE), J2.2, J4.1, J5.1 (A), P1.6 (GND), P1.9 (GND), P1.14 (GND), P1.20 (GND), P1.25 (GND), P1.30 (GND), P1.34 (GND), P1.39 (GND), SW1.2, U5.1 (A0), U5.2 (A1), U5.4 (VSS); also elsewhere on the board
unnamed: D7.1 (ANODE), R30.2
unnamed: J2.1, R6.2, U5.7 (WP)
unnamed: J4.2, R29.2, R31.2, SW1.1
unnamed: J5.2 (C), U5.3 (A2)
unnamed: J25.1 (A), P1.26 (~CE1~/GPIO7)
unnamed: J25.2 (C), R29.1
unnamed: J29.1 (A), P1.33 (PWM1/GPIO13)
unnamed: J29.2 (B), R30.1
PI_3V3: C1.1, J5.3 (B), P1.1 (3V3), P1.17 (3V3), R6.1, R31.1, R34.1, R35.1, TP9.1, U5.8 (VCC); also elsewhere on the board
PI_5V: P1.2 (5V), P1.4 (5V); also elsewhere on the board

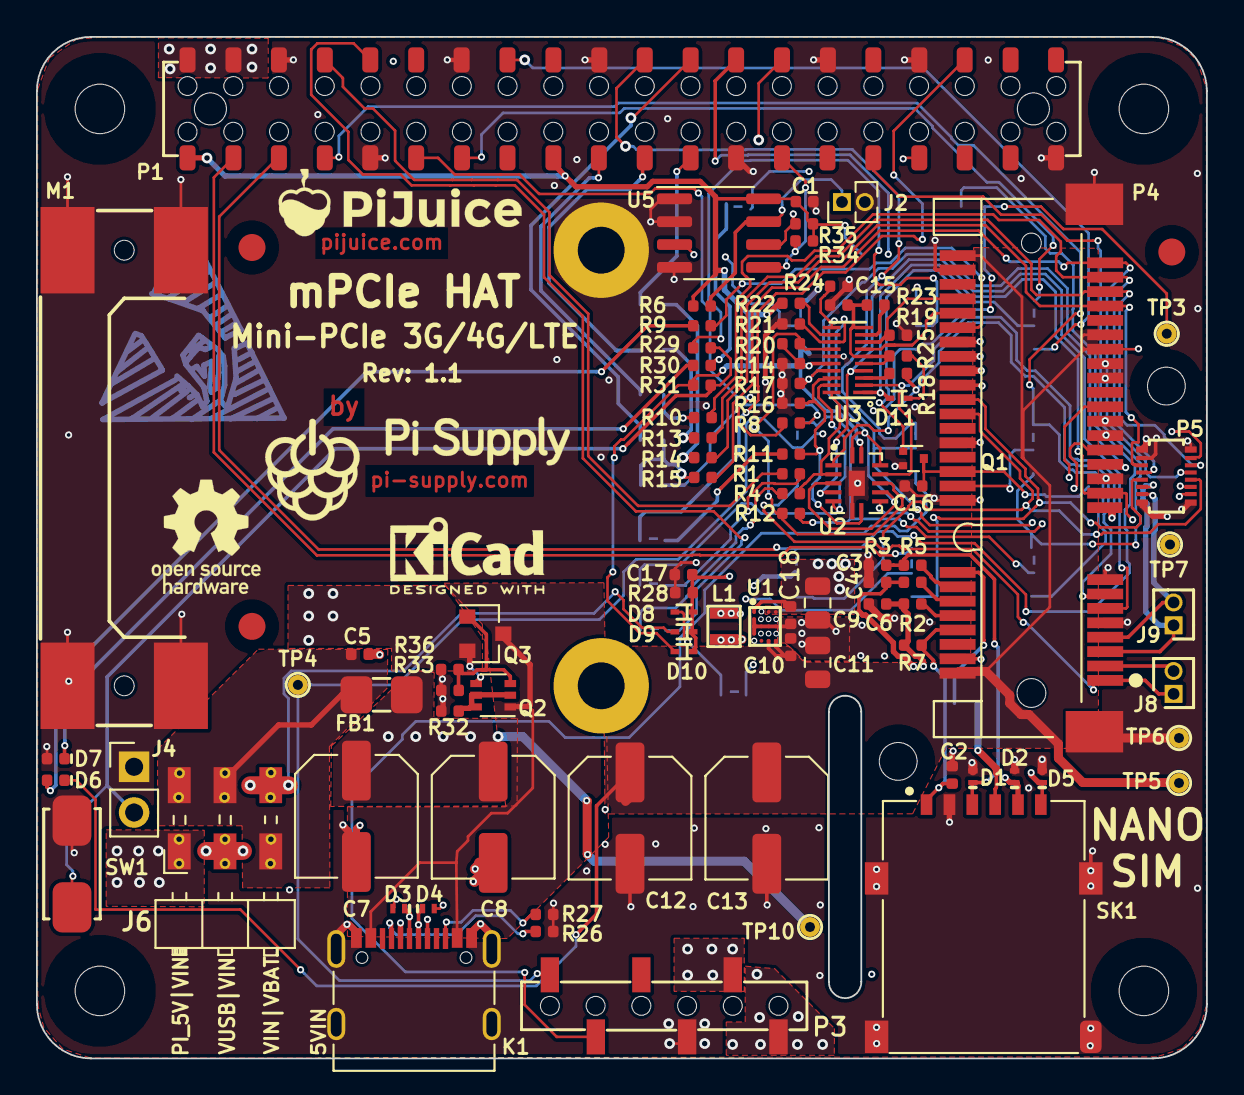
[picture p21: board mPCIe_HAT.kicad_pcb from above]

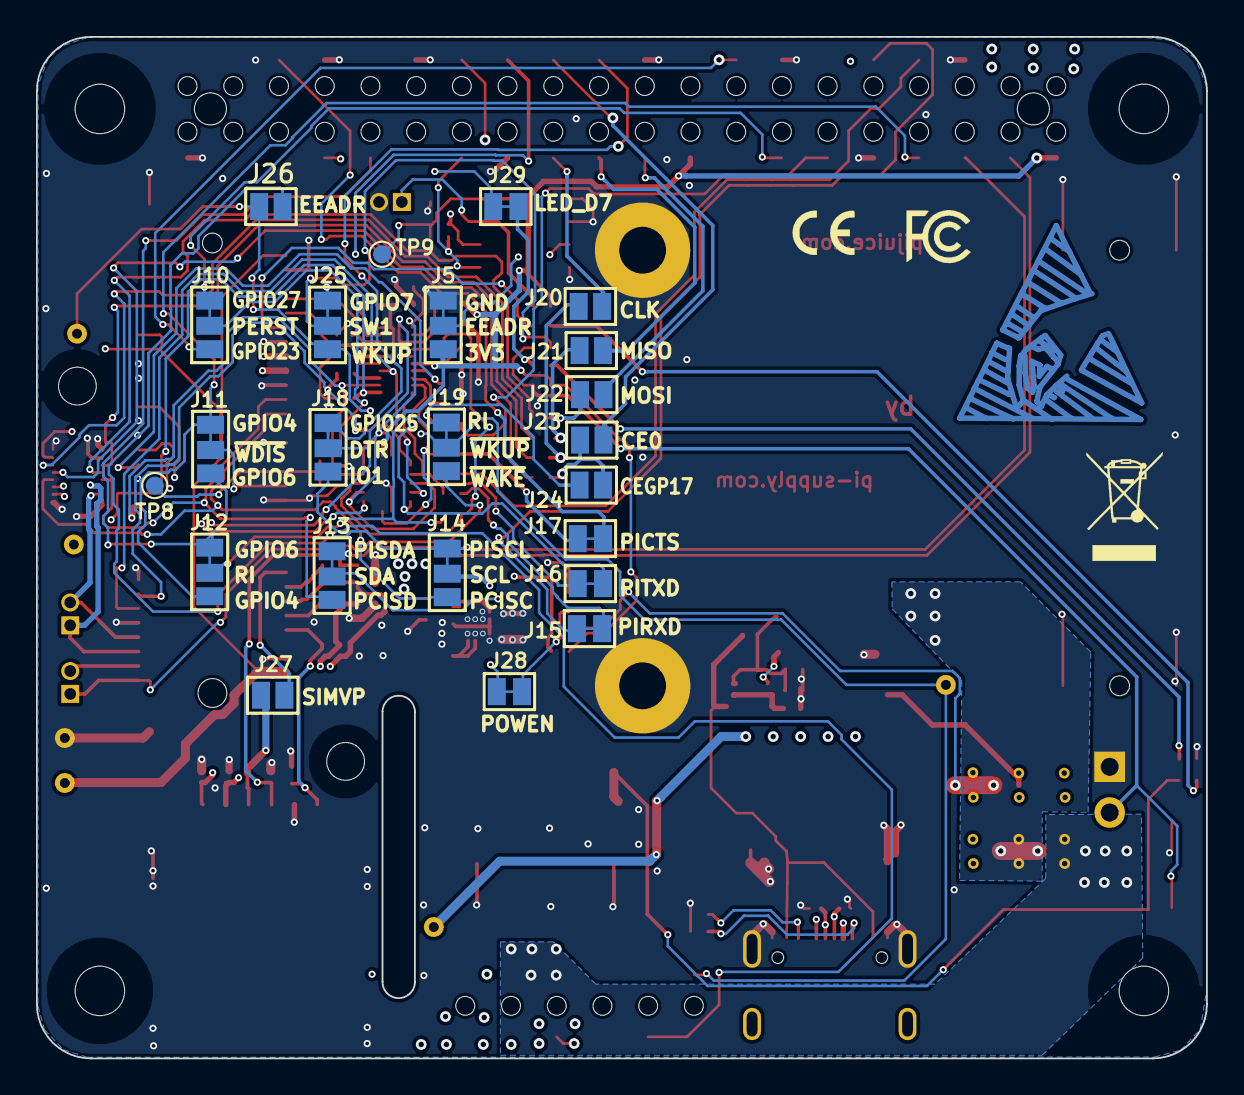
[picture p22: board mPCIe_HAT.kicad_pcb from below]

Board: 4 copper layers, 65.0 x 56.8 mm, 135 parts (27 on the bottom side), 99 nets.
