PiSupply/PiJuice-mPCIe/Hardware/Test_card/mPCIe_test_card.kicad_pcb

## KiCad design Hardware/Test_card/mPCIe_test_card.kicad_pcb (2021-05-11)

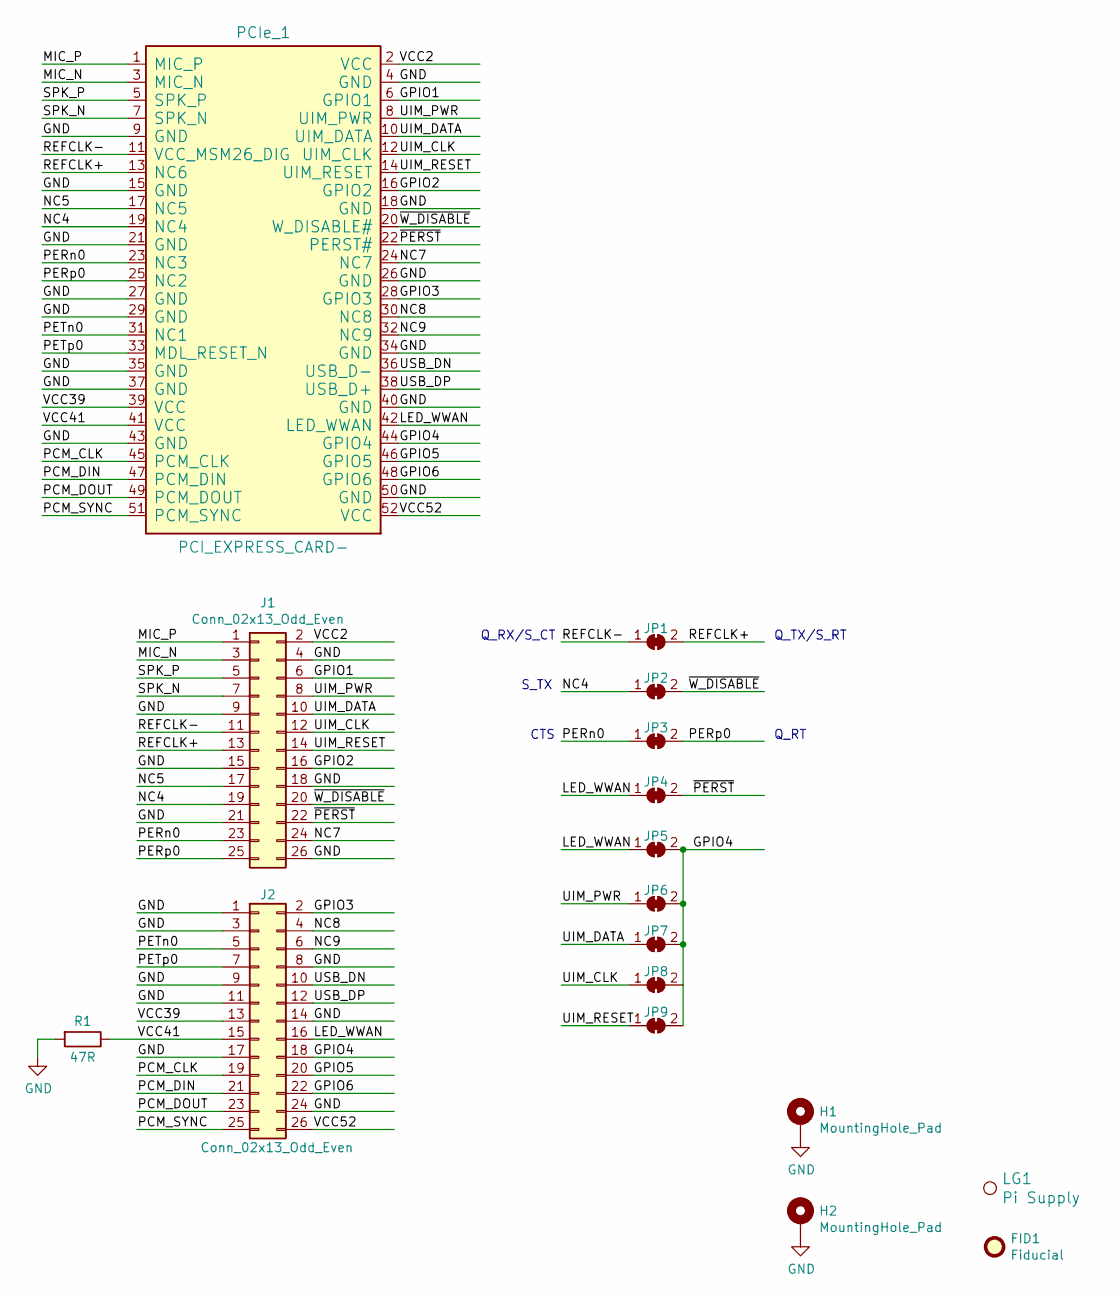
[picture p23: schematic mPCIe_test_card.sch]

Parts:
FID1: Fiducial; Fiducial_0.75mm_Mask1.5mm
H1, H2: MountingHole_Pad; MountingHole
J1, J2: Conn_02x13_Odd_Even; PinHeader_2x13_P2.54mm_Vertical
JP1, JP2, JP3, JP4, JP5, JP6, JP7, JP8, JP9: SolderJumper_2_Bridged; SolderJumper-2_P1.3mm_Bridged
LG1: Pi Supply; PiSupply
PCIe_1: PCI_EXPRESS_CARD-; PCIeMini-GF-2D-800-1K-S52
R1: 47R; R_Axial_DIN0414_L11.9mm_D4.5mm_P15.24mm_Horizontal; Part Number KNP100FR-73-47R

Connections:
/GPIO1: J1.6, PCIe_1.6 (GPIO1)
/GPIO2: J1.16, PCIe_1.16 (GPIO2)
/GPIO3: J2.2, PCIe_1.28 (GPIO3)
/GPIO4: J2.18, JP5.2 (B), JP6.2 (B), JP7.2 (B), JP8.2 (B), JP9.2 (B), PCIe_1.44 (GPIO4)
/GPIO5: J2.20, PCIe_1.46 (GPIO5)
/GPIO6: J2.22, PCIe_1.48 (GPIO6)
/LED_WWAN: J2.16, JP4.1 (A), JP5.1 (A), PCIe_1.42 (LED_WWAN)
/MIC_N: J1.3, PCIe_1.3 (MIC_N)
/MIC_P: J1.1, PCIe_1.1 (MIC_P)
/NC4: J1.19, JP2.1 (A), PCIe_1.19 (NC4)
/NC5: J1.17, PCIe_1.17 (NC5)
/NC7: J1.24, PCIe_1.24 (NC7)
/NC8: J2.4, PCIe_1.30 (NC8)
/NC9: J2.6, PCIe_1.32 (NC9)
/PCM_CLK: J2.19, PCIe_1.45 (PCM_CLK)
/PCM_DIN: J2.21, PCIe_1.47 (PCM_DIN)
/PCM_DOUT: J2.23, PCIe_1.49 (PCM_DOUT)
/PCM_SYNC: J2.25, PCIe_1.51 (PCM_SYNC)
/PERn0: J1.23, JP3.1 (A), PCIe_1.23 (NC3)
/PERp0: J1.25, JP3.2 (B), PCIe_1.25 (NC2)
/PETn0: J2.5, PCIe_1.31 (NC1)
/PETp0: J2.7, PCIe_1.33 (MDL_RESET_N)
/REFCLK+: J1.13, JP1.2 (B), PCIe_1.13 (NC6)
/REFCLK-: J1.11, JP1.1 (A), PCIe_1.11 (VCC_MSM26_DIG)
/SPK_N: J1.7, PCIe_1.7 (SPK_N)
/SPK_P: J1.5, PCIe_1.5 (SPK_P)
/UIM_CLK: J1.12, JP8.1 (A), PCIe_1.12 (UIM_CLK)
/UIM_DATA: J1.10, JP7.1 (A), PCIe_1.10 (UIM_DATA)
/UIM_PWR: J1.8, JP6.1 (A), PCIe_1.8 (UIM_PWR)
/UIM_RESET: J1.14, JP9.1 (A), PCIe_1.14 (UIM_RESET)
/USB_DN: J2.10, PCIe_1.36 (USB_D-)
/USB_DP: J2.12, PCIe_1.38 (USB_D+)
/VCC2: J1.2, PCIe_1.2 (VCC)
/VCC39: J2.13, PCIe_1.39 (VCC)
/VCC41: J2.15, PCIe_1.41 (VCC), R1.1
/VCC52: J2.26, PCIe_1.52 (VCC)
/~PERST~: J1.22, JP4.2 (B), PCIe_1.22 (PERST#)
/~W_DISABLE~: J1.20, JP2.2 (B), PCIe_1.20 (W_DISABLE#)
GND: H1.1, H2.1, J1.4, J1.9, J1.15, J1.18, J1.21, J1.26, J2.1, J2.3, J2.8, J2.9, J2.11, J2.14, J2.17, J2.24, PCIe_1.4 (GND), PCIe_1.9 (GND), PCIe_1.15 (GND), PCIe_1.18 (GND), PCIe_1.21 (GND), PCIe_1.26 (GND), PCIe_1.27 (GND), PCIe_1.29 (GND), PCIe_1.34 (GND), PCIe_1.35 (GND), PCIe_1.37 (GND), PCIe_1.40 (GND), PCIe_1.43 (GND), PCIe_1.50 (GND), R1.2

Notes on the sheet:
CTS
Q_RT
S_TX
Q_RX/S_CT
Q_TX/S_RT

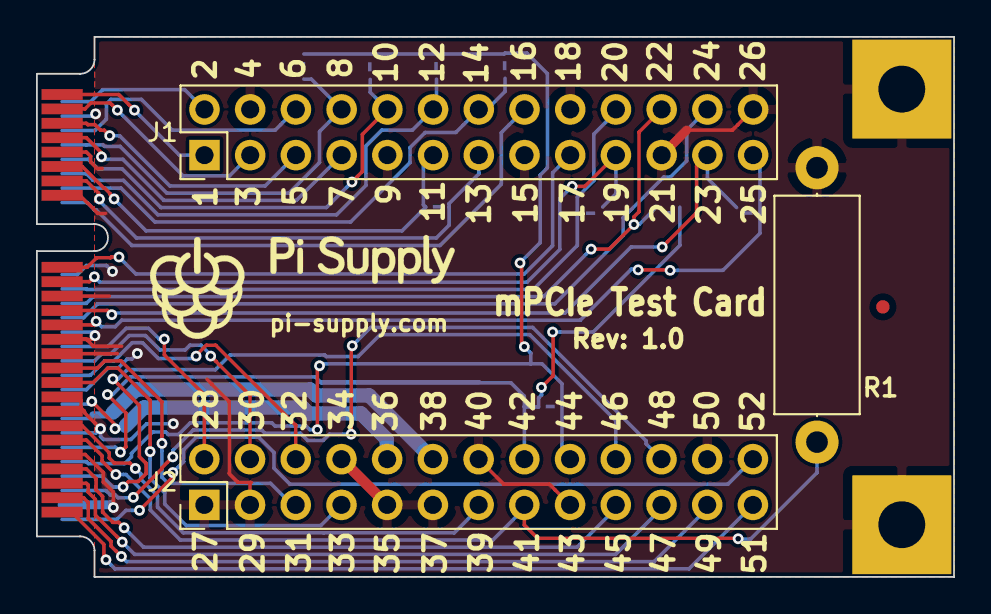
[picture p24: board mPCIe_test_card.kicad_pcb from above]

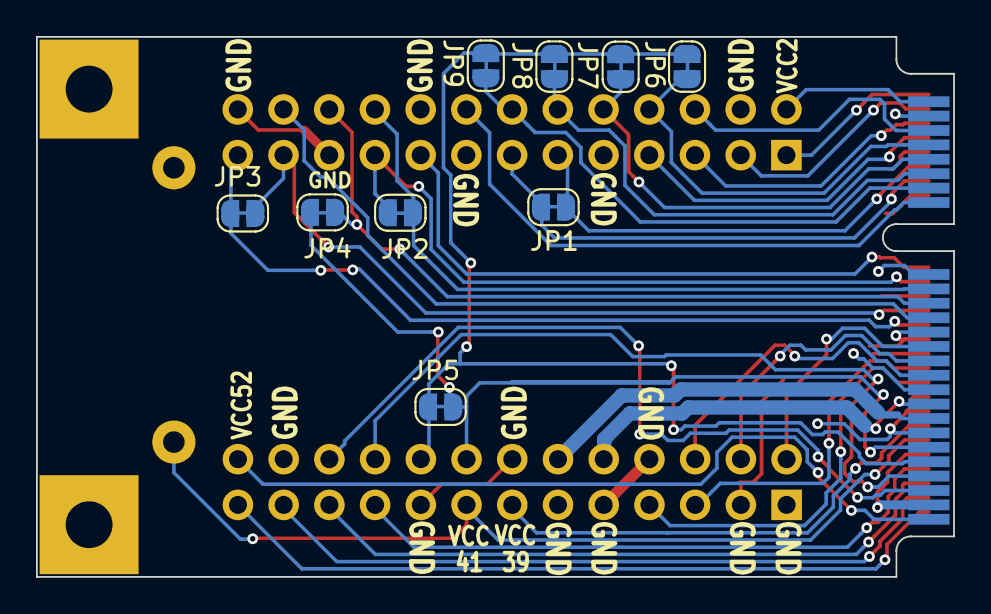
[picture p25: board mPCIe_test_card.kicad_pcb from below]

Board: 2 copper layers, 50.9 x 30.0 mm, 17 parts (9 on the bottom side), 39 nets.
