PiSupply/PiJuice-mPCIe/(commit log)

2021-02-25 Added interactive BOM
2021-02-25 PCB Library Created
2021-02-25 Added PCB Library footprints
2021-05-11 Initial Design Rev 1.0
    [mPCIe_test_card.kicad_pcb, mPCIe_test_card.sch, mPCIe_test_card_BOM.csv]
2021-12-30 Q2B connection fix, position file generated.
    [RPI_port-SchDoc.sch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]
